irish-bug/ChromaCade/docs/TSynth.png

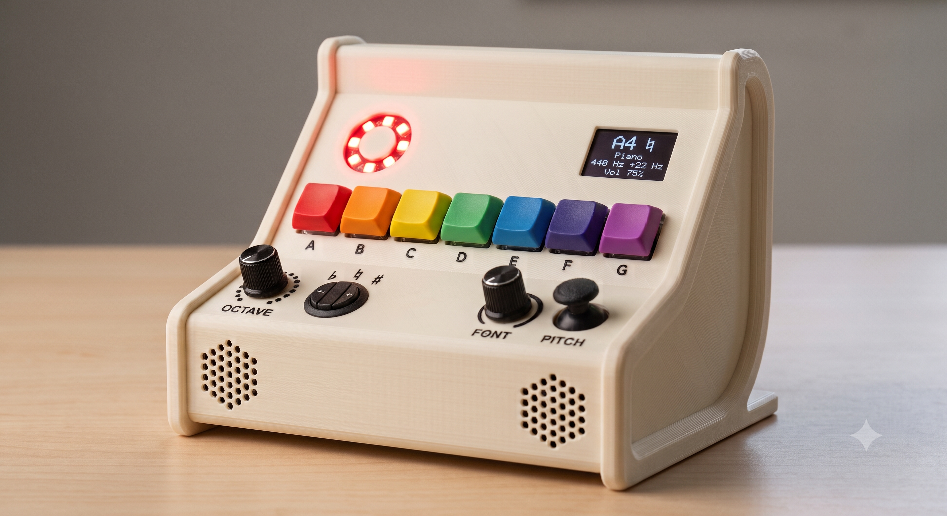
docs/TSynth.png
