irish-bug/ChromaCade/README.md

# ChromaCade
ChromaCade: A learning platform for young musicians. This project aims to create a robust and intuitive self exploration musical learning platform for musically precocious toddlers of all ages.
