irish-bug/ChromaCade/hardware/control-layout.md

# Control Layout — Toddler Synth

## Physical zones

**Main angled panel (45°):**
- 7 note buttons (MX switches, rainbow keycaps), left to right = low to high, letter names A–G
- OLED display (note name, font, frequency+bend, volume)
- WS2812 LED ring, mounted next to the OLED

**Shelf (flat, slight forward tilt, between front wall and angled panel):**
- **Far left:** octave encoder (EC11, detented, wraps 1→2→3→4→1) + flat/natural/sharp rocker switch (3-way, ON-OFF-ON), positioned together as the left-hand "setup" cluster
- **Far right:** font/voice encoder (EC11, detented, wraps through voice list) + pitch-bend joystick (KY-023, spring-centered, one axis), positioned together as the right-hand "live shaping" cluster

**Side panel:**
- Volume pot (Fender 500K) — deliberately less convenient than shelf/panel controls

**Front wall:**
- Two speaker grilles (small hex hole pattern, sized to keep toddler fingers out)

**Back wall:**
- USB-C charging port — out of reach during normal play
- Power switch (miniature snap-in rocker, 19.2×12.7mm panel cutout) — moved here from the side panel; same deliberate-friction reasoning, and grouping it with the charging port keeps both "parent-only" power-path controls out of reach during play

## Normal play behavior
- Direct GPIO wiring (no button matrix) — full chord support, no ghosting, any combination of the 7 note buttons can be held simultaneously
- Flat/natural/sharp switch is **global** — applies to all currently-held notes uniformly. A chord can be all-natural or all-modified, never mixed (e.g. no C–E–G♯ chords). This is an accepted, deliberate simplification (see design-philosophy.md).
- Octave applies globally too, via the octave encoder — not per-note
- Pitch-bend joystick affects all currently-held notes' pitch together, live, while held; snaps back to zero on release (spring-centered)
- LED ring shows a **unified color** for the whole ring (not per-note-position) — reflects the currently-played note's base hue, shifted warmer for sharp / cooler for flat. Chord color-blending behavior is an open question — see open-questions.md.
- OLED shows four lines, live-updating: note+accidental (large), font name, base frequency + signed pitch-bend offset in Hz (shown separately, not summed — e.g. "440 Hz +22 Hz" — to reinforce that bend modifies rather than replaces the note), volume percentage

## Menu / mode interaction grammar
Designed to survive toddler mashing — every menu action requires a multi-control combo, since a plain long-press on a note button is not a safe gesture on its own (toddlers routinely hold single notes just to sustain the sound — see "Corrected 2026-08-15" below for why that matters).

- **Toggle mode menu (open from anywhere else, close from the menu):** hold **both** encoder push-buttons (octave encoder's and font encoder's) together for ~1.5s. From an active Tutor/Simon session this stops the session and opens the menu; from the menu itself it closes back to Play.
- **Cycle through menu options:** turn the font encoder (menu takes over that control's normal job while a menu is open)
- **Select a highlighted option:** short click of the font encoder's push-button

**Simplified 2026-08-16 — dropped the note-button long-press.** Previously this was hold-both-encoders **and** long-press an edge note button (B to enter, C to exit) — see history below for why it was two notes and both encoders in the first place. In practice the extra note-button press just added friction without adding safety: both encoder push-buttons held together is already a two-handed, opposite-ends-of-the-shelf signal on its own, rare enough that a third simultaneous note-button long-press wasn't buying meaningfully more protection against toddler mashing. Collapsing enter/exit into one toggle (state-dependent: open the menu unless already in it, in which case close it) also removes the need to remember two different notes for two different directions.

**Corrected 2026-08-15 — was originally A/G + font-button-only, implemented as C/B + both-encoder-buttons:** two separate issues, fixed together (superseded by the 2026-08-16 simplification above, kept here for history).
1. This section originally said "long-press G to enter, A to exit," reasoning that they were the two edge buttons — true under the *old* alphabetical A-G labeling, but the 2026-08-15 relabel to C-D-E-F-G-A-B moved the physical edges to C and B; A and G became interior buttons. Updated the letters to match, not the underlying "edge button" reasoning.
2. The original design paired the font button alone (as a held modifier) with the note-button long-press. In practice a note-button long-press isn't a rare, deliberate signal — a toddler sustaining a single held note *is* a long-press, all day, during completely normal play. Requiring **both** encoder push-buttons (not just the font one) closes that gap: they sit at opposite ends of the shelf (far left = octave, far right = font), so holding both down is inherently two-handed and not something normal note-sustaining play does incidentally.

This also resolves the octave encoder push-button's previously-unassigned function (see hardware-bom.md/open-questions.md history): it's one of the two buttons in this gesture, not read for anything else yet.

**Note on implementation:** the font encoder's push-button is overloaded across two contexts — held-as-modifier (menu toggle, alongside the octave button) and short-click (menu selection). Implemented in `hardware_poller.py` via a press/release timestamp (short click) plus a `threading.Timer` armed the instant both encoder buttons are simultaneously down and cancelled the instant either releases, so the gesture only fires if both stayed held for the full ~1.5s — see that module's docstring for the exact approach.

**Resolved 2026-08-15 (was open):** A/C/B/G note buttons do *not* play notes while a menu is active — the menu takes over input entirely, confirmed as implemented in `chromacade.py`. Visual feedback: the OLED switches to a menu view (mode/song list, current selection marked), and the LED ring clears while a menu is open. Menu structure is nested (mode select, then a song list within Tutor) — see `menu.py`. No song preview/snippet plays before selecting.
