irish-bug/ChromaCade/enclosure/ChromaCade-wordmark.png

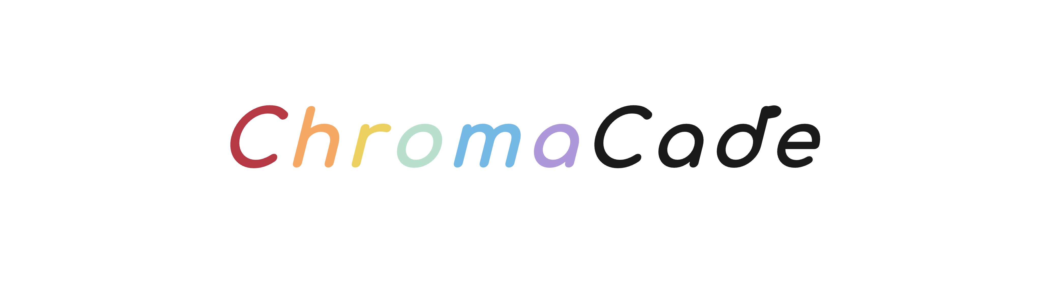
enclosure/ChromaCade-wordmark.png
