irish-bug/ChromaCade/enclosure/fan-dimensions.jpg

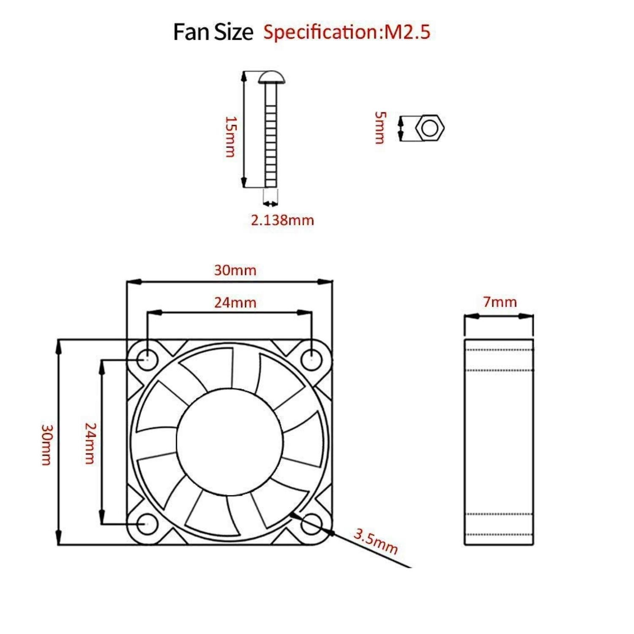
enclosure/fan-dimensions.jpg
