irish-bug/ChromaCade/hardware/speaker_specs.jpeg

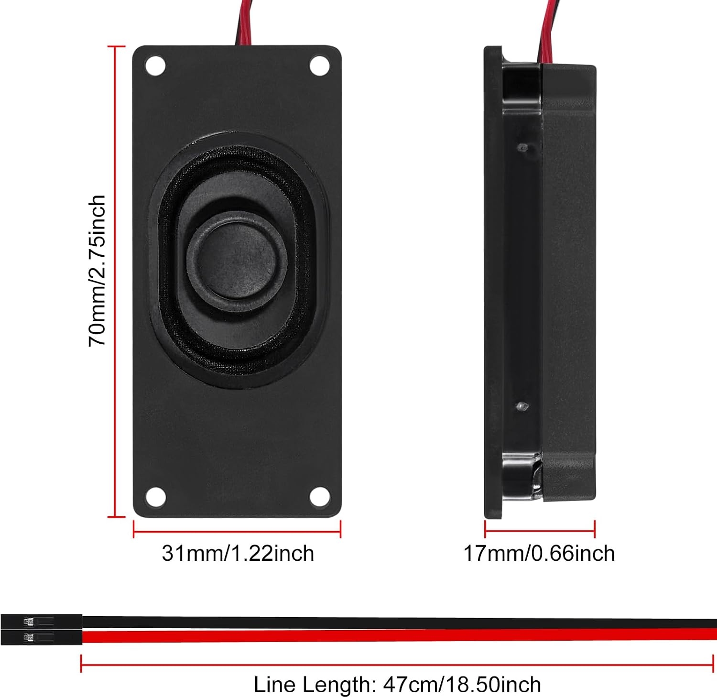
hardware/speaker_specs.jpeg
