irish-bug/ChromaCade/enclosure/chromacade-housing.stl

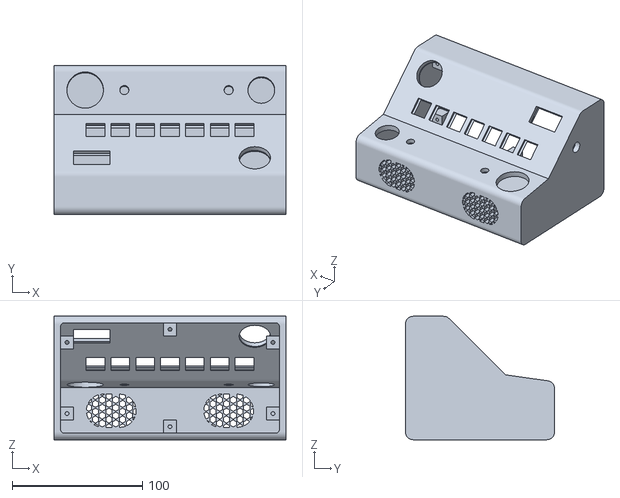
[picture p5: CAD file, 2026-07-22]
enclosure/chromacade-housing.stl
177.8 x 114.3 x 94.7
