irish-bug/ChromaCade/enclosure/deprecated/sphere-removed.stl

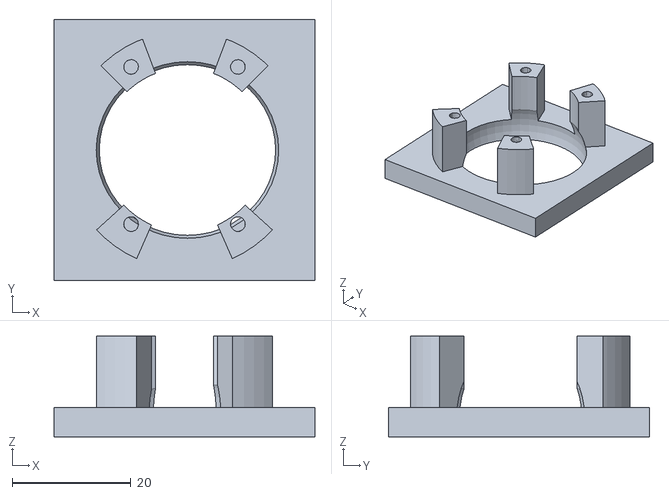
[picture p7: CAD file, 2026-08-28, an earlier design]
enclosure/deprecated/sphere-removed.stl
44.0 x 44.0 x 17.0
