irish-bug/ChromaCade/enclosure/deprecated/chromacade-pot-side.stl

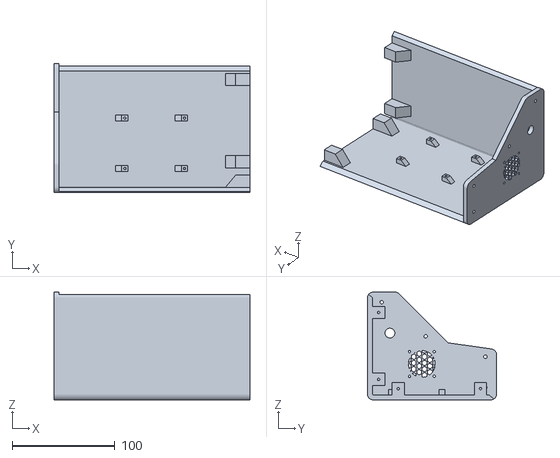
[picture p8: CAD file, 2026-08-28, an earlier design]
enclosure/deprecated/chromacade-pot-side.stl
190.4 x 125.7 x 104.9
