irish-bug/ChromaCade/enclosure/deprecated/test-mk2.stl

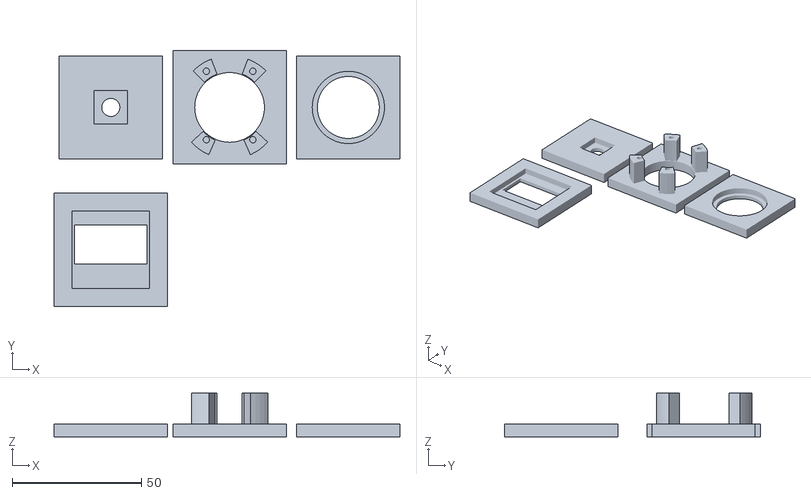
[picture p9: CAD file, 2026-08-28, an earlier design]
enclosure/deprecated/test-mk2.stl
134.0 x 99.0 x 17.0
