irish-bug/ChromaCade/enclosure/deprecated/chromacade-blank-side.stl

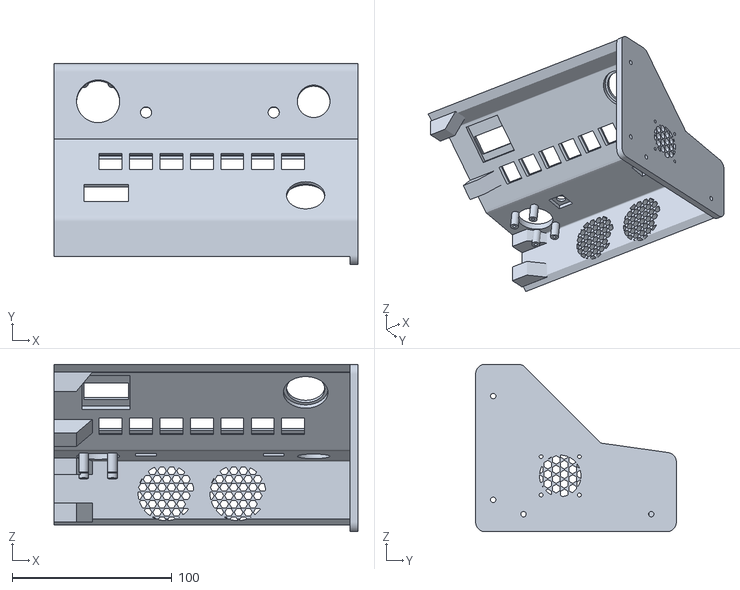
[picture p10: CAD file, 2026-08-28, an earlier design]
enclosure/deprecated/chromacade-blank-side.stl
190.4 x 125.7 x 104.9
