irish-bug/ChromaCade/(list of files, cad)

Other CAD files:
enclosure/blank-side-one-off.scad
enclosure/chromacade-housing.scad
enclosure/deprecated/chromacade-blank-side-embossed.scad
enclosure/deprecated/chromacade-blank-side-thinner.scad
enclosure/deprecated/chromacade-blank-side.scad
enclosure/deprecated/chromacade-fit-check-thinner.scad
enclosure/deprecated/chromacade-fit-check.scad
enclosure/deprecated/chromacade-housing.scad
enclosure/deprecated/chromacade-pot-side-thinner.scad
enclosure/deprecated/chromacade-pot-side.scad
enclosure/deprecated/joystick-mount-dev.scad
enclosure/deprecated/test-mk2.scad
