irish-bug/ChromaCade/testing/led_ring16_test.py

#!/usr/bin/env python3
"""
ChromaCade -- candidate "NeoPixel Ring 16" bench test.

Not the project's decided ring/strip (see led_ring_test.py for those) --
this is a bench evaluation of a different, not-yet-committed 16-LED ring
being tried as a possible swap-in. Wire only 3 of its 6 pads for this
test: 5V, GND, and DIN. Leave the unlabeled pad and the "Power & Signal"
pad disconnected until their function is confirmed (e.g. via a
continuity check against the 4 known pads) -- guessing at those risks
frying the ring or a GPIO pin.

    DIN -> GPIO12, PHYSICAL PIN 32 (PWM0) -- NOT physical pin 12.
           Physical pin 12 is GPIO18, which this build's I2S audio
           (WM8960 HAT) already claims for BCLK -- see
           gpio-pin-assignments.md's WS2812 ring entry, which calls
           this out by name as "a common conflict with the default
           rpi_ws281x example code". GPIO12/pin 32 is the pin the
           project's real ring already uses successfully.
    VCC -> Pi 5V rail
    GND -> any Pi GND

Cycles 7 generic/textbook RGB values (not this project's tuned
docs/color-palette.md hexes -- see led_ring_test.py's history or
git blame on this file for those) -- red, orange, yellow, green, blue,
purple, pink, in that order. Just a plain color-rendering check for
this candidate ring, not a comparison against the project's actual
palette.

Prerequisites:
    pip3 install adafruit-circuitpython-neopixel --break-system-packages

Must be run with sudo -- WS2812 output on the Pi uses PWM/DMA hardware
that needs root access.

Usage:
    sudo python3 led_ring16_test.py
    sudo python3 led_ring16_test.py --num-pixels 16 --hold 1.5
    sudo python3 led_ring16_test.py --pixel-order RGB   # if colors look swapped
    sudo python3 led_ring16_test.py --rgb 255,75,0      # hold one color, tune live, Ctrl+C to stop
"""

import argparse
import sys
import time

try:
    import board
    import neopixel
except ImportError:
    print("Missing dependency. Install with:")
    print("    pip3 install adafruit-circuitpython-neopixel --break-system-packages")
    sys.exit(1)

# All 7 live-tuned against this specific candidate ring via --rgb,
# 2026-08-20. Started from full-saturation primaries for red/green/blue
# (matching led_ring_test.py's own COLOR_STEPS convention) and generic/
# textbook CSS values for the rest -- green reads stronger than its
# numeric value on this hardware, same effect docs/color-palette.md
# found on the project's real ring (see that file for the general
# phenomenon). Every entry ended up far dimmer than its starting point,
# not just rebalanced -- full CSS/full-saturation brightness read as
# washed-out/pastel (purple specifically read as pink at CSS 128,0,128),
# same effect color-palette.md describes for the project's real ring.
# Converged on a max-channel-88 ceiling across the whole set (~1/3 of
# full output, chosen for that headroom -- and, not incidentally, 88mph).
#
# Confirmed 2026-08-20, seeing all 7 together at the 88 ceiling: lower
# intensity doesn't just fix individual problem colors, it makes EVERY
# color read more distinct and "less white" across the board, not only
# the ones that were visibly wrong at full brightness. Consistent with
# color-palette.md's "additive light reads washed-out near-white"
# point, but sharper -- it's specifically an intensity effect, not just
# additive-vs-reflective: even colors that looked fine alone at full
# brightness (red/green/blue) read more washed out than they needed to,
# it just wasn't obvious until compared side by side with the dimmed
# set. Worth keeping in mind for any future WS2812 palette work, not
# just this ring: check a candidate color's distinctness at a lower
# ceiling before assuming full-saturation is the right starting point.
COLORS = [
    ("red",    (88, 0, 0)),      # TUNED 2026-08-20 (was full-sat 255,0,0)
    ("orange", (88, 15, 0)),     # TUNED 2026-08-20 (was CSS 255,165,0; first pass 255,50,0)
    ("yellow", (88, 55, 0)),     # TUNED 2026-08-20 (was CSS 255,255,0; passes 255,190,0, 125,85,0, 88,60,0)
    ("green",  (0, 88, 0)),      # TUNED 2026-08-20 (was full-sat 0,255,0)
    ("blue",   (0, 0, 88)),      # TUNED 2026-08-20 (was full-sat 0,0,255)
    ("purple", (40, 0, 88)),     # TUNED 2026-08-20 (was CSS 128,0,128; first pass 10,0,24)
    ("pink",   (88, 0, 35)),     # TUNED 2026-08-20 (was CSS 255,192,203; first pass 255,0,100)
]


def main():
    parser = argparse.ArgumentParser(description="ChromaCade candidate 16-LED ring bench test")
    parser.add_argument("--pin", default="D12",
                         help="board pin attribute for DIN (default D12 = GPIO12 = physical pin 32)")
    parser.add_argument("--num-pixels", type=int, default=16,
                         help="pixel count (default 16, per the ring's name -- override if it's actually different)")
    parser.add_argument("--brightness", type=float, default=0.2,
                         help="0.0-1.0, conservative default to keep current draw low on the bench (default 0.2)")
    parser.add_argument("--hold", type=float, default=1.0,
                         help="seconds to hold each color (default 1.0)")
    parser.add_argument("--pixel-order", default="GRB", choices=["RGB", "GRB"],
                         help="most WS2812/WS2812B are GRB; try RGB if colors come out swapped (default GRB)")
    parser.add_argument("--rgb", default=None,
                         help="skip the sequence and hold one custom color instead, e.g. --rgb 255,75,0 "
                              "-- for iterating on a value live without a re-push/re-pull round trip; "
                              "holds until Ctrl+C")
    args = parser.parse_args()

    order = neopixel.GRB if args.pixel_order == "GRB" else neopixel.RGB

    try:
        pixel_pin = getattr(board, args.pin)
    except AttributeError:
        print(f"ERROR: board.{args.pin} not found -- check your adafruit-blinka install/platform detection.")
        sys.exit(1)

    try:
        pixels = neopixel.NeoPixel(
            pixel_pin, args.num_pixels, brightness=args.brightness,
            auto_write=False, pixel_order=order,
        )
    except PermissionError:
        print("ERROR: permission denied initializing the chain.")
        print("WS2812 output needs PWM/DMA hardware access -- run this with sudo:")
        print("    sudo python3 led_ring16_test.py")
        sys.exit(1)

    print(f"Candidate ring -- board.{args.pin}, {args.num_pixels} pixels, pixel_order={args.pixel_order}")
    print("If colors look swapped (e.g. red shows as green), re-run with --pixel-order RGB.")
    print("If the first pixel looks wrong/flickery while the rest are fine, that's the classic")
    print("3.3V-GPIO-driving-a-5V-chain symptom -- a logic-level shifter (74AHCT125) may be needed.")
    print()

    if args.rgb:
        try:
            r, g, b = (int(x) for x in args.rgb.split(","))
        except ValueError:
            print(f"ERROR: --rgb must be R,G,B e.g. --rgb 255,75,0 (got {args.rgb!r})")
            sys.exit(1)
        print(f"Holding ({r},{g},{b}) -- Ctrl+C to stop")
        pixels.fill((r, g, b))
        pixels.show()
        try:
            while True:
                time.sleep(3600)
        except KeyboardInterrupt:
            print("\nStopped.")
        finally:
            pixels.fill((0, 0, 0))
            pixels.show()
        return

    try:
        for name, rgb in COLORS:
            print(f"  {name:8s} {rgb}")
            pixels.fill(rgb)
            pixels.show()
            time.sleep(args.hold)
        print("Sequence complete.")
    except KeyboardInterrupt:
        print("\nInterrupted.")
    finally:
        pixels.fill((0, 0, 0))
        pixels.show()


if __name__ == "__main__":
    main()
