irish-bug/ChromaCade/test_audio_engine.py

import pytest

from audio_engine import (
    FONTS,
    NOTE_SEMITONES,
    VOLUME_CEILING,
    bent_letter,
    clamp_octave,
    font_index_change,
    joystick_bend_fraction,
    midi_note,
    midi_to_freq,
    pitch_bend_value,
    pot_volume_fraction,
    rocker_accidental,
    smooth,
    volume_midi_value,
)


def test_note_semitones_covers_all_seven_letters():
    assert set(NOTE_SEMITONES.keys()) == {"C", "D", "E", "F", "G", "A", "B"}


def test_c4_is_midi_60():
    assert midi_note("C", octave=4) == 60


def test_a4_is_midi_69_the_440hz_reference():
    assert midi_note("A", octave=4) == 69


def test_midi_69_is_440hz():
    assert midi_to_freq(69) == pytest.approx(440.0)


def test_midi_to_freq_one_octave_up_doubles():
    assert midi_to_freq(69 + 12) == pytest.approx(880.0)


def test_midi_to_freq_one_octave_down_halves():
    assert midi_to_freq(69 - 12) == pytest.approx(220.0)


def test_all_seven_letters_at_octave_4():
    expected = {"C": 60, "D": 62, "E": 64, "F": 65, "G": 67, "A": 69, "B": 71}
    for letter, note in expected.items():
        assert midi_note(letter, octave=4) == note


def test_octave_shift_moves_by_twelve_semitones():
    assert midi_note("C", octave=5) - midi_note("C", octave=4) == 12
    assert midi_note("C", octave=3) - midi_note("C", octave=4) == -12


def test_sharp_raises_one_semitone():
    assert midi_note("C", octave=4, accidental=1) == midi_note("C", octave=4) + 1


def test_flat_lowers_one_semitone():
    assert midi_note("C", octave=4, accidental=-1) == midi_note("C", octave=4) - 1


def test_octave_0_and_8_match_the_confirmed_range():
    # feature-spec.md: 8 octaves, C0-C8, confirmed via live speaker sweep
    assert midi_note("C", octave=0) == 12
    assert midi_note("C", octave=8) == 108


def test_clamp_octave_moves_within_range():
    assert clamp_octave(4, 1) == 5
    assert clamp_octave(4, -1) == 3


def test_clamp_octave_stops_at_the_confirmed_floor_and_ceiling():
    assert clamp_octave(0, -1) == 0
    assert clamp_octave(8, 1) == 8


def test_clamp_octave_handles_a_runaway_gesture_in_one_step():
    # a whole burst of clicks still only ever moves one octave per
    # commit()ed gesture, but clamp_octave itself should be safe even
    # if called with a larger delta than that
    assert clamp_octave(0, -5) == 0
    assert clamp_octave(8, 5) == 8


def test_rocker_accidental_natural_when_neither_throw_active():
    assert rocker_accidental(flat_active=False, sharp_active=False) == 0


def test_rocker_accidental_flat_throw():
    assert rocker_accidental(flat_active=True, sharp_active=False) == -1


def test_rocker_accidental_sharp_throw():
    assert rocker_accidental(flat_active=False, sharp_active=True) == 1


def test_rocker_accidental_both_active_is_a_wiring_fault_falls_back_natural():
    assert rocker_accidental(flat_active=True, sharp_active=True) == 0


def test_joystick_bend_fraction_at_center_is_zero():
    assert joystick_bend_fraction(1.65) == pytest.approx(0.0, abs=0.01)


def test_joystick_bend_fraction_low_voltage_is_positive_sharp():
    # confirmed inverted as wired -- forward push reads as lower voltage
    # but should mean sharp/positive bend
    assert joystick_bend_fraction(0.0) == pytest.approx(1.0, abs=0.01)


def test_joystick_bend_fraction_high_voltage_is_negative_flat():
    assert joystick_bend_fraction(3.3) == pytest.approx(-1.0, abs=0.01)


def test_joystick_bend_fraction_clamped_past_measured_extremes():
    assert joystick_bend_fraction(-1.0) == 1.0
    assert joystick_bend_fraction(5.0) == -1.0


def test_pitch_bend_value_zero_at_center():
    assert pitch_bend_value(0.0) == 0


def test_pitch_bend_value_half_semitone_up_at_full_positive_bend():
    assert pitch_bend_value(1.0, max_semitones=0.5) == 1024


def test_pitch_bend_value_half_semitone_down_at_full_negative_bend():
    assert pitch_bend_value(-1.0, max_semitones=0.5) == -1024


def test_pitch_bend_value_clamped_to_valid_synth_range():
    assert pitch_bend_value(1.0, max_semitones=10) == 8191
    assert pitch_bend_value(-1.0, max_semitones=10) == -8192


def test_bent_letter_no_bend_stays_the_same_letter():
    assert bent_letter("C", 0.0) == "C"


def test_bent_letter_e_to_f_is_only_a_half_step():
    # E-F is one of the two half-step pairs -- crosses with a small bend
    # (0.6 semitones of actual bend clears the 0.5-semitone halfway point)
    assert bent_letter("E", 0.6, max_semitones=1.0) == "F"


def test_bent_letter_c_to_d_is_a_whole_step_needs_more_bend():
    # same 0.6-semitone bend that flips E->F should NOT flip C->D
    # (2 semitones apart, halfway point is 1.0 semitones)
    assert bent_letter("C", 0.6, max_semitones=1.0) == "C"


def test_bent_letter_c_to_d_does_flip_with_enough_bend():
    assert bent_letter("C", 1.0, max_semitones=1.0) == "D"


def test_bent_letter_b_to_c_wraps_the_octave_boundary_correctly():
    # B-C is the other half-step pair, and it's the wraparound case
    assert bent_letter("B", 0.6, max_semitones=1.0) == "C"


def test_bent_letter_negative_bend_crosses_to_the_previous_letter():
    assert bent_letter("C", -0.6, max_semitones=1.0) == "B"


def test_bent_letter_stays_home_just_under_the_halfway_point():
    assert bent_letter("E", 0.49, max_semitones=1.0) == "E"


def test_bent_letter_large_bend_crosses_two_boundaries_not_just_one():
    # G bent up a full 4 semitones lands exactly on B's pitch (7+4=11),
    # past A (9) -- must not stop at the first neighbor
    assert bent_letter("G", 1.0, max_semitones=4.0) == "B"


def test_bent_letter_large_bend_partway_between_two_boundaries_shows_middle_letter():
    # G bent up exactly 2 semitones lands exactly on A -- confirms the
    # multi-boundary walk stops at the right letter, not overshooting
    assert bent_letter("G", 0.5, max_semitones=4.0) == "A"


def test_smooth_alpha_one_tracks_new_value_instantly():
    assert smooth(previous=1.0, new_value=2.0, alpha=1.0) == 2.0


def test_smooth_alpha_zero_ignores_new_value_entirely():
    assert smooth(previous=1.0, new_value=2.0, alpha=0.0) == 1.0


def test_smooth_alpha_half_averages_the_two():
    assert smooth(previous=1.0, new_value=3.0, alpha=0.5) == 2.0


def test_pot_volume_fraction_zero_volts_is_silent():
    # No longer inverted -- rewiring since the original 2026-08-14
    # calibration flipped which direction reads high vs low voltage,
    # confirmed live 2026-08-24 (see audio_engine.py's comment).
    assert pot_volume_fraction(0.0) == pytest.approx(0.0, abs=0.01)


def test_pot_volume_fraction_full_voltage_is_full_clockwise_full_volume():
    assert pot_volume_fraction(3.3) == pytest.approx(1.0, abs=0.01)


def test_pot_volume_fraction_clamped_past_measured_extremes():
    assert pot_volume_fraction(-1.0) == 0.0
    assert pot_volume_fraction(5.0) == 1.0


def test_volume_midi_value_zero_is_silent():
    assert volume_midi_value(0.0) == 0


def test_volume_midi_value_full_volume_stops_at_the_safety_ceiling():
    # ceiling default is 0.7 -- full pot turn should never reach 127
    assert volume_midi_value(1.0) == round(0.7 * 127)


def test_volume_midi_value_custom_ceiling():
    assert volume_midi_value(1.0, ceiling=1.0) == 127
    assert volume_midi_value(1.0, ceiling=0.5) == round(0.5 * 127)


def test_volume_midi_value_gamma_curve_boosts_low_and_mid_positions():
    # sqrt(0.25) = 0.5, so the default gamma curve should give roughly
    # double the MIDI value a straight linear mapping would at this
    # pot position -- this is the actual fix for the reported "silent
    # through the lower two-thirds" issue
    linear_equivalent = round(0.25 * VOLUME_CEILING * 127)
    curved = volume_midi_value(0.25)
    assert curved > linear_equivalent


def test_volume_midi_value_gamma_endpoints_unaffected():
    # a gamma curve preserves 0.0 and 1.0 exactly regardless of gamma
    assert volume_midi_value(0.0, gamma=0.3) == 0
    assert volume_midi_value(1.0, gamma=0.3) == round(VOLUME_CEILING * 127)


def test_font_index_change_steps_forward_and_backward():
    assert font_index_change(0, 1, num_fonts=5) == 1
    assert font_index_change(2, -1, num_fonts=5) == 1


def test_font_index_change_wraps_past_the_end():
    assert font_index_change(4, 1, num_fonts=5) == 0


def test_font_index_change_wraps_past_the_start():
    assert font_index_change(0, -1, num_fonts=5) == 4


def test_fonts_list_has_no_duplicate_display_names():
    names = [name for _, name in FONTS]
    assert len(names) == len(set(names))


def test_fonts_list_has_no_duplicate_gm_programs():
    programs = [program for program, _ in FONTS]
    assert len(programs) == len(set(programs))
