irish-bug/ChromaCade/(commit log)

2026-07-18 Add parametric OpenSCAD case model (v2)
    - Arcade-cabinet profile: foot → front wall → shelf → 45° panel → back wall
    - Continuous base slab; all dims parametric at top of file
    - Shelf tilt geometry: polyhedron (flat bottom, 7.5° tilted top); back
    edge rises SHELF_D*tan(7.5°) ≈ 6.7mm relative to front edge
    - Panel base position updated to SHELF_BACK_TOP_Z to match tilted shelf
    - 7 MX switch cutouts (19.05mm pitch), OLED window, LED ring on 45° panel
    - Shelf cutouts: octave encoder + rocker switch (left), font encoder +
    joystick (right); extended height to clear full tilted face
    - Front wall: dual hex speaker grilles (<6mm holes, toddler-safe)
    - Side panel: volume pot + power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
    [chromacade.scad]
2026-07-18 Rename case design document to ChromaCade
2026-07-18 Revise ChromaCade model to version 3
    Updated ChromaCade model to version 3 with structural fixes, improved geometry, and additional features. Changed all face sizes and increased rounding of edges.
    [chromacade.scad]
2026-07-18 Fix comments for synthesizer components in chromacade.scad
    Updated comments to reflect correct component names for the synthesizer model.
    [chromacade.scad]
2026-07-18 Refactor mounting boss and cutout placements
    [chromacade.scad]
2026-07-18 Upgrade ChromaCade Synthesizer to V4
    Updated ChromaCade Synthesizer model to V4 with improvements to back wall, mounting bosses, and back panel screw holes.
    [chromacade.scad]
2026-07-18 Add V4 structural model with BOM-verified cutout corrections
    Based on Shane's V4 paste with all cutout dimensions corrected against
    hardware-bom.md and three-key-test-mount.scad:
    MX switch holes 14.0 → 14.3mm FDM tolerance per test mount
    KY-023 joystick d=10 → d=30mm thumb cap is ~27mm; 10mm blocked it
    XINYIELE rocker d=8 → d=12mm 12mm round body per part spec
    EC11 encoders d=16 → d=7mm M7 bushing OD; 16mm left sloppy gap
    USB-C port 15×7 → 10×4mm standard USB-C receptacle is 9.5×3.5mm
    Speaker grilles circular hex_grill(30) → rect_hex_grill(65, 30)
    Speaker enclosures are rectangular (1-3/8" × 2-3/4" = 34.9×69.9mm).
    Grille sized to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
    [chromacade-v4.scad]
2026-07-18 Add 6-hole component fit test plate
    One 40x40mm plate per unique cutout type, all flat-printable in one go.
    Lets you verify every hole before the full case print.
    A MX switch 14.3 × 14.3mm (1.5mm eng layer + 4mm frame, per test mount)
    B KY-023 joy ø30mm
    C XINYIELE ø12mm
    D EC11 enc ø7mm
    E USB-C 10 × 4mm rect
    F Fender pot ø8mm
    Raised text labels on top face. Includes per-plate tuning notes as comments.
    [test-component-holes.scad]
2026-07-18 Upgrade ChromaCade Synthesizer to V5
    Updated ChromaCade Synthesizer model to V5 with structural improvements and corrected cutout dimensions for various components.
    [chromacade.scad]
2026-07-18 Fix rocker switch hole: 12mm → 20.32mm (0.8 inch spec)
    Previous 12mm was a guess based on generic round rocker convention.
    Shane confirmed the XINYIELE body requires 0.8" = 20.32mm panel hole.
    Updated in both chromacade-v4.scad and test-component-holes.scad.
    [chromacade-v4.scad, test-component-holes.scad]
2026-07-18 Add test plates for LED ring and OLED display, fix rocker comments
    [test-component-holes.scad]
2026-07-18 Revise cutouts based on printed test results; add mk2 test plates
    BOM-verified corrections applied to chromacade.scad:
    - Rocker: d=12 (regression) → d=20.5 (confirmed snug fit from test print)
    - Joystick: d=30 → d=28, Y offset removed (re-centred)
    - Encoders: d=7 kept; add 14.3×14.3mm back countersink 1mm deep for thread clearance
    - OLED: 28×15 front window kept; add 30×30mm back countersink 2mm deep
    - LED ring: d=24 front aperture (exposes full 23mm LED circle); d=28 back recess 1mm
    deep — ring glues in from behind, ~1.3mm gap around 25.4mm PCB
    - USB-C: 10×4 → 14×10 to accommodate cable sheath over bare receptacle
    - Speaker grilles: rect_hex_grill(65,30) → stadium_hex_grill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
    [chromacade.scad, test-component-holes.scad, test-mk2.scad]
2026-07-18 Remove labels from JOY, LED, OLED test plates to prevent print failures
    Labels on all three overlapped with their cutouts (d=28 hole/recess fills
    the 40mm plate, OLED 30×30 countersink undercuts the label position).
    ENC and SPK labels are clear of their cutouts and unchanged.
    [test-mk2.scad]
2026-07-18 Fix countersink faces and rotate speaker grilles 90°
    Speaker grilles: add rotate([0,0,90]) — was portrait (1"×1.5" tall),
    now landscape (1.5"×1" wide) to match the front wall proportions.
    Countersink Z positions: all three were at -(wall-depth)/2 which placed
    them mid-wall rather than at the interior face. Interior face is at
    local Z=-wall, so correct center positions are -(wall-depth/2):
    - Encoder (1mm): -(wall-1)/2=-2 → -(wall-0.5)=-4.5
    - OLED (2mm): -(wall-2)/2=-1.5 → -(wall-1) =-4
    - LED ring(1mm): -(wall-1)/2=-2 → -(wall-0.5)=-4.5
    [chromacade.scad]
2026-07-18 Add STL of the unit.
    Unit with verified cutout sizes, sinks, and dimensions.
    [chromacade.stl]
2026-07-19 Extract speaker grilles into separate printable inserts
    Printing upright (the intended orientation) puts the grilles right beneath
    the shelf overhang. The resulting support material would clog the tiny
    hex holes and be incredibly tedious to scrape out.
    - Replaced the hardcoded hex grilles on the front wall with open 65x30mm windows.
    - Created a new module.
    - Insert features a 5mm mounting rim to glue/tape to the inside of the front wall.
    - Insert is 2mm thick (thinner than case walls for better acoustics) and
    prints flat on the bed.
    [chromacade-v4.scad]
2026-07-19 Upgrade grille inserts to stepped flush-mount design with screw flanges
    - Grille insert now features a 5mm plug that sits flush with the exterior face of the case.
    - Base of insert is a 2mm flange that sits against the inside wall.
    - Added 4x 2.5mm screw holes to the corners of the flange.
    - Added corresponding blind pilot holes to the inside of the front wall (they go 3mm deep, leaving the front face perfectly clean).
    [chromacade-v4.scad]
2026-07-19 Consolidate to single chromacade.scad file and bump to Version 6
    - Removed the separate chromacade-v4.scad file.
    - We are now tracking versions through standard git history and a changelog header in the main chromacade.scad file.
    - Logged the recent V6 upgrades (stepped flush grilles with screw flanges).
    [chromacade-v4.scad, chromacade.scad]
2026-07-19 Split monolithic SCAD into modular files
    - Extracted global variables to `chromacade-config.scad`.
    - Extracted grille inserts to `speaker-grille-insert.scad`.
    - Extracted back panel to `back-panel.scad`.
    - Renamed main file to `chromacade-housing.scad`, which uses/includes the other files.
    [back-panel.scad, chromacade-config.scad, chromacade-housing.scad, chromacade.scad, speaker-grille-insert.scad]
2026-07-19 Disable back panel preview in housing for clean STL exports
    [chromacade-housing.scad]
2026-07-19 Revert to monolithic file with export toggles
    User's workflow relies on pasting raw code directly into unsaved OpenSCAD windows
    on a separate machine. The modular architecture broke this workflow.
    Consolidated back into a single `chromacade.scad` file, and added boolean
    toggles at the very top of the file to choose which part to render and export.
    [back-panel.scad, chromacade-config.scad, chromacade-housing.scad, chromacade.scad, speaker-grille-insert.scad]
2026-07-19 Completely unlinked standalone files
    User requested 3 entirely independent files with no shared dependencies
    to mimic the distribution style of Printables/Thingiverse.
    Variables were duplicated into each file so they can be copy-pasted or
    downloaded and rendered completely on their own.
    [chromacade-back-panel.scad, chromacade-housing.scad, chromacade-speaker-grilles.scad, chromacade.scad]
2026-07-19 Restore component countersinks to hardware_cutouts
    Accidentally dropped the EC11, OLED, and LED ring back sinks during the
    refactor from V4 to V5. Also finally added the MX switch trench to the main
    model (3.5mm deep, leaving a 1.5mm front face for the clips to engage, just
    like in the test plates).
    [chromacade-housing.scad]
2026-07-19 Shift shelf components to clear side walls
    User noted the joystick cutout (at -70) was colliding with the side wall.
    Shifted the joystick from X=-70 to -65, and shifted the left EC11 encoder
    from X=-45 to -35 to maintain clearance.
    [chromacade-housing.scad]
2026-07-19 Fix speaker grille flange collision and back panel bowing
    - Redesigned the speaker grille flange to only extend left and right, ensuring
    it stays within the bounds of the internal front cavity. The top and bottom
    edges were colliding with the shelf ceiling and case floor. Pilot holes in the
    housing were adjusted accordingly.
    - Added top and bottom center mounting bosses to the housing and corresponding
    screw holes to the back panel to prevent the long span from bowing out.
    [chromacade-back-panel.scad, chromacade-housing.scad, chromacade-speaker-grilles.scad]
2026-07-19 Fix floating center bosses, cut grilles into front wall, relocate power switch
    - Removed the top/bottom center mounting bosses added in the previous commit
    to fight back-panel bowing — render confirms they were floating/disconnected
    from the shell (unprintable), and no replacement fix exists yet.
    - Replaced the rectangular speaker grille + separate screwed insert with a
    landscape stadium (pill) hex-hole pattern cut straight into the front wall
    (stadium_hex_grill module), matching the validated test-mk2.scad plate E
    design. Deleted chromacade-speaker-grilles.scad and the stale chromacade.stl
    that predated the file split.
    - Restored print-confirmed rocker (20.5mm) and joystick (2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
    [chromacade-back-panel.scad, chromacade-housing.scad, chromacade-housing.stl, chromacade-speaker-grilles.scad, chromacade.stl]
2026-07-19 Square off mounting bosses for full contact with the side wall
    The round boss (d=10) was positioned exactly one radius from the side
    wall's inner face, so it only ever line-contacted the flat wall at a
    single tangent point instead of bonding to it — a weak connection and
    a real risk of a barely-fused, snap-off boss when printed. Squaring
    the outer cross-section to 10x10mm (still centered on the same axis,
    same screw-hole diameter) puts a full flush 10x10mm face against the
    wall in its place. Render-confirmed manifold, still a single connected
    solid (no new floating geometry or collisions).
    [chromacade-housing.scad]
2026-07-19 Add center top/bottom bosses for back-panel anti-bowing support
    Reintroduces the center bosses removed earlier (they floated: reused
    the side bosses' X-inset at x=0, where there's no side wall to touch).
    This time they're Z-offset instead of X-offset — 5mm in from the
    ceiling/floor's inner surface — so the square boss (from the previous
    commit) sits flush against the ceiling/floor rather than touching
    nothing. Render-confirmed still a single connected volume, same as
    before adding them.
    Back panel gets two matching 3.5mm screw holes at the same x=0
    position to bolt into the new bosses.
    [chromacade-back-panel.scad, chromacade-housing.scad]
2026-07-19 Add wordmark-embossed housing variant
    Separate standalone file (chromacade-housing-embossed.scad), not a
    toggle in the base housing file, matching this repo's file-per-variant
    convention. Raises "ChromaCade" 1mm proud of the panel exterior,
    centered in the gap between the OLED and LED ring cutouts (x=3.5,
    the midpoint of their facing edges), sized to 84x11mm to clear both
    the button row above and the panel edges.
    Uses OpenSCAD's native text() with Comfortaa Bold (installed via apt;
    falls back to a default font if missing) plus a manual shear to
    approximate the source wordmark's italic style, since Comfortaa ships
    no italic face. The letters' extrusion starts 0.3mm inside the wall
    rather tha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
    [chromacade-housing-embossed.scad]
2026-07-19 Record note key color palette
    Adds color-palette.md with the hex values for the note key colors.
    Letter-to-color assignment and chord-blend validation are still open
    (cross-referenced from open-questions.md's existing "physical button
    color vs. ring color mapping" item, not resolving it outright).
    Also fixes CLAUDE.md's file list, which still described the deleted
    chromacade-speaker-grilles.scad insert file, and adds the missing
    chromacade-housing-embossed.scad entry from the previous commit.
2026-07-19 Switch wordmark emboss to the traced-path SVG
    Replaces the text()+shear approximation with a direct import of
    ChromaCade-wordmark-paths.svg (real bold-italic bezier outlines) so
    the emboss no longer depends on Comfortaa being installed on whatever
    machine renders/slices it — that font-substitution mismatch was why
    the first print came out in a plain, non-bold, non-italic font.
    Positioning bug caught before this went out again: centering used a
    bounding-box center measured by round-tripping the import through an
    SVG re-export, but that export silently negates Y on the way out, so
    the value was off-sign. Re-measured the true center via an extruded
    STL export instead (79.9-284.2mm x, 40.7-62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
    [chromacade-housing-embossed.scad]
2026-07-19 Embed wordmark outline as literal polygon data, drop import()
    Converts ChromaCade-wordmark-paths.svg's line-segment path data into
    embedded wordmark_points/wordmark_paths arrays and switches
    wordmark_emboss() to polygon(points=..., paths=...) instead of
    import("ChromaCade-wordmark-paths.svg"). The conversion is exact (the
    source paths are already flattened to straight segments, no curves
    approximated).
    Reason: import() requires OpenSCAD to read a second local file, which
    prompted a filesystem-permission dialog on at least one setup and got
    declined without realizing it was for the wordmark SVG sitting right
    there — silently breaking the emboss. Embedding removes that
    dependency entirely,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
    [chromacade-housing-embossed.scad]
2026-07-19 Fix wordmark orientation: rotate 180 degrees to match real facing direction
    Second upside-down print. Root cause: I'd been validating orientation
    by eyeballing renders from arbitrary, never-actually-verified camera
    angles, so my "looks right side up" judgment calls weren't grounded in
    the toy's real facing direction and got it backwards twice.
    Fixed properly this time: derived a camera aimed mathematically straight
    down the panel's own outward normal (computed from panel_a and the p3/p4
    midpoint, not eyeballed), then validated it against known, unambiguous
    geometry — LED ring is a circle, OLED is a rectangle, and per the user
    the LED should read on their left, OLED on their right, with th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
    [chromacade-housing-embossed.scad]
2026-07-20 Add print settings for ELEGOO NEPTUNE 3 Pro
2026-07-20 Log software-setup decisions and open GAIN question from today's hardware bring-up
    Records the hifiberry-dac/asound.conf/no-venv calls made during the 3-key
    test mount + amp #1 bring-up so future sessions don't re-propose the
    tutorial-default max98357a overlay or a venv-based setup. Adds the still-open
    amp GAIN pin choice to open-questions.md.
2026-07-20 Update GAIN status: wired to GND (12dB), still not loud enough
    Resolves the floating-vs-GND part of the open question from earlier today;
    15dB-via-100k-resistor is the next thing to try if 12dB alone doesn't get
    loud enough.
2026-07-20 Bump note_test.py AMPLITUDE to 0.9 for loudness check, fix stale comment
    [note_test.py]
2026-07-20 Fix stale doc/comment references from the wordmark-embossed switch
    - CLAUDE.md: correct chromacade.stl -> chromacade-housing.stl, document
    printsettings, and mark chromacade-housing-embossed.scad as the current
    primary housing model (plain variant kept until its print is validated)
    - chromacade-housing-embossed.scad: drop the leftover Comfortaa-font header
    comment, which no longer matches the embedded-polygon wordmark approach
    [chromacade-housing-embossed.scad]
2026-07-20 Reorganize repo into docs/, hardware/, enclosure/, testing/, audio/
    Consolidates shane/seed-project-docs, artoo/case-openscad-model, and
    hardware-config (which no longer needed a separate branch once main gets
    this structure) into one folder layout instead of a flat root, grouping
    files by function rather than by which branch happened to add them:
    - docs/ design/decision docs, open questions, team/task breakdown
    - hardware/ electronics docs (GPIO map, BOM, control layout)
    - enclosure/ the OpenSCAD case model + printable assets + fit-test plates
    - testing/ hardware bring-up/bench-test scripts + session test-plan docs
    - audio/ placeholder only -- brian/core-audio-engine (PR #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
    [chromacade-back-panel.scad, chromacade-housing-embossed.scad, chromacade-housing.scad, chromacade-housing.stl, test-component-holes.scad, test-mk2.scad]
2026-07-21 Add ADS1115 bring-up test, lock its channel/address wiring, verify amp #2
    - Document the single ADS1115's ADDR/A0/A1/VDD/GND wiring in
    gpio-pin-assignments.md: ADDR->GND (address 0x48), A0=volume pot,
    A1=joystick axis.
    - Add testing/ads1115_test.py: live-reads both channels so pot/joystick
    wiring can be confirmed on the bench, with a min/max/span summary to
    catch a flat/stuck channel.
    - audio_test.py: turn the "listen for both speakers" step into an actual
    interactive pass/fail check now that amp #2 exists, and update the
    stale amp-#1-only expectation text.
    [ads1115_test.py, audio_test.py]
2026-07-21 Document post-push sync step to the physical chromacade board
    After pushing, SSH to the chromacade host and git pull its
    /home/shane/ChromaCade/ checkout to keep it in sync -- with a safety
    check first (clean working tree, branch actually tracks what was pushed).
2026-07-21 Fix ADS1115 A0/A1 assignment to match hardware_poller.py, not an invented one
    Swap: A0=joystick axis, A1=volume pot. The Adafruit ADS1x15 library's
    ADS.P0/P1 constants just name physical A0/A1, not a separate channel
    numbering, so this has to match Brian's already-written
    joystick_chan=P0 / volume_chan=P1 rather than a channel order I made up
    before checking his code.
    [ads1115_test.py]
2026-07-22 Fix regressed volume pot side-hole: 8mm -> 9.525mm (3/8") for Fender 500K
    Unit #1 needed the hole hand-drilled out to fit the pot's mounting
    bushing. Fixed in both chromacade-housing.scad and
    chromacade-housing-embossed.scad (same shared cutout, copy-pasted per
    the file-split convention) and regenerated chromacade-housing.stl.
    [chromacade-housing-embossed.scad, chromacade-housing.scad, chromacade-housing.stl]
2026-07-22 Document OLED, LED ring, switch, and encoder wiring
    - OLED: SDA/SCL join the shared I2C bus, VCC/GND connections.
    - LED ring: only the input triad (DIN/5V/GND) is needed, not all 6
    breakout pads -- the other triad is for daisy-chaining a second
    ring/strip this build doesn't have. Note the 3.3V-GPIO-driving-5V-chain
    logic-level caveat and its usual symptom/fix.
    - EC11 encoders and the 3-way rocker: continuity-based method for
    identifying Common/switch-leg pins when the physical layout isn't
    obviously labeled, since it varies by manufacturer.
2026-07-22 Add WS2812 LED ring bring-up test
    Solid red/green/blue/white fills (catches a wrong GRB/RGB pixel-order
    default) followed by a one-at-a-time walk across all 7 pixels (catches
    a dead/miswired individual LED). Needs sudo for PWM/DMA access, unlike
    the plain-gpiozero scripts elsewhere in testing/. Turns the ring off on
    exit rather than leaving it lit.
    [led_ring_test.py]
2026-07-22 Document confirmed Jewel-style ring + planned interior backlighting strip
    - BOM/gpio-pin-assignments: ring is Jewel-style (6 outer + 1 center),
    confirmed via bring-up test -- chain walks the outer 6 then lights
    center last.
    - Plan an interior NeoPixel strip for whole-case backlighting through
    unit #1's translucent PLA shell, chained off the ring's spare OUT
    triad (same GPIO12 line, no new GPIO). Logged in decision-log.md,
    BOM'd as planned/not-yet-sourced, noted as a power-budget item to
    recheck once a length is picked.
    - feature-spec/open-questions: interior strip as a second lighting
    channel for Simon/Tutor mode feedback, exact behavior still open.
2026-07-22 Add flat/natural/sharp rocker switch bring-up test
    Reports FLAT/NATURAL/SHARP on every change; flags if flat and sharp
    ever read active simultaneously, since that's a wiring problem (not a
    real position) on this single-pole switch.
    [rocker_test.py]
2026-07-22 Add SSD1306 OLED bring-up test
    Border rectangle + text to confirm the panel is actually alive (not
    just I2C-detected), then a full-panel invert flash to check every
    pixel independent of the drawing code, then clears.
    [oled_test.py]
2026-07-22 Fix oled_test.py: use Pillow instead of framebuf's .text()
    adafruit_framebuf's built-in .text() needs a separate font5x8.bin
    bitmap file that pip doesn't bundle -- fails with a bare
    FileNotFoundError on a fresh install. Pillow's default font avoids the
    extra asset dependency, and is the more standard approach for
    SSD1306-over-Blinka anyway.
    [oled_test.py]
2026-07-22 Fix ads1115_test.py: ADS.P0/P1 constants don't exist in library 3.0.5
    A fresh pip install currently pulls adafruit-circuitpython-ads1x15
    3.0.5, which dropped the old ADS.P0/P1 named constants in favor of
    plain integers 0-3 for AnalogIn's positive_pin. hardware_poller.py
    uses the old ADS.P0/P1 spelling and would hit the same AttributeError
    if actually run against this version -- noted in the docstring.
    [ads1115_test.py]
2026-07-22 Temporarily disable joystick channel in ads1115_test.py -- not wired yet, just clutters pot-only checks
2026-07-22 Note pot's inverted voltage-to-volume direction, confirmed via bring-up test
2026-07-22 Re-enable joystick channel in ads1115_test.py -- now wired
2026-07-22 Add EC11 rotary encoder bring-up test (octave/font)
    Uses gpiozero's RotaryEncoder for quadrature decoding/debouncing.
    Reports CW/CCW clicks and button presses live, with a summary count on
    exit -- turning through known detent counts in each direction should
    match what's reported, confirming no double-counts or skips.
    [encoder_test.py]
2026-07-23 Document speaker-vs-shelf clearance bug found on unit #1
    hardware_cutouts() only cuts the speaker grille opening, never modeled
    the physical speaker's depth against the shelf's right-side components
    (joystick especially, at shelf x=-65, most outboard on that side).
    Unit #1 shipped with the speaker trimmed by hand (deadline fix, not a
    CAD change) -- next print needs a real depth measurement and an actual
    geometry fix, logged as an open question.
2026-07-23 Add FluidSynth smoke test, staged for when the Pi's back online
    Untested as of this commit -- ChromaCade's Pi was powered off, so this
    is written and syntax-checked only, ready to pull and run the moment
    it's back. Informed by nektar-synth (separate project) already running
    fluidsynth + FluidR3_GM.sf2 successfully on identical Pi Zero 2W
    hardware, which resolves the main feasibility risk before any of this
    touches the real audio engine. Logged as an explicitly-deferred
    open question in open-questions.md -- not starting real integration
    before the Saturday deadline.
    [fluidsynth_test.py]
2026-07-23 Gitignore downloaded audio assets and their fetch script
    Third-party copyrighted sound clips (for a planned boot notification
    chime) do not belong in this public repo, nor does the script that
    fetches them. Both stay local-only on-device.
2026-07-24 Fix fluidsynth_test.py: sfload() failure isn't an exception, it's -1
    Found this the hard way -- a missing soundfont file caused fluidsynth's
    own C-level error logging to print, but pyfluidsynth's sfload() just
    returned -1 rather than raising, so the try/except never fired and the
    script happily printed "Done" after a real load failure.
    [fluidsynth_test.py]
2026-07-24 Fix fluidsynth_test.py: default gain too quiet, add --gain
    pyfluidsynth's synth.gain default (0.2) is much quieter than
    nektar-synth's proven `-g 3.0` command-line flag -- the equivalent
    Python setting was simply missing. Confirmed on real hardware: default
    produced a "very brief and quiet" note; added --gain (default 3.0,
    matching nektar-synth) as the fix.
    [fluidsynth_test.py]
2026-07-24 Add boot-ready chime script and systemd unit
    Plays OOT_Navi_Hello1.wav once at boot (5s delay for audio hardware
    init, matching nektar-synth's margin) to signal the device has
    finished starting up. The wav itself stays gitignored/local-only; this
    is just the script + unit that reference it.
2026-07-24 Lock in interior strip LED count: 16 (23 total with the ring)
    Chosen 2026-07-24, comfortably within the ~25-LED power budget at
    brightness 0.3 computed earlier -- no need to redo that math. Also
    noted: ring+strip share one WS2812 chain but remain individually
    addressable per-pixel, so the planned "alternate, never simultaneous"
    behavior is a UX choice, not a wiring constraint.
2026-07-24 Add pinout to the gpio-pin-assignments.md
2026-07-25 Extend led_ring_test.py to the full 23-pixel ring+strip chain
    Defaults to 23 (7-pixel ring + 16-pixel strip), with --num-pixels to
    override (e.g. 7 to test just the ring before the strip is wired).
    Walk test now labels which pixel index belongs to the ring vs. the
    strip when running the full chain.
2026-07-25 Bump audio_test.py default --seconds 1.5 -> 15 for bench multimeter tests
    Longer window needed to get a probe positioned and read a fluctuating
    meter during AC-voltage-while-playing style tests.
2026-07-29 Fix ads1115_test.py raw/voltage mismatch: two separate I2C reads per line
    .voltage and .value were each triggering their own ADC conversion, so
    the printed pair could reflect two different samples (e.g. raw=5060
    paired with voltage=-0.015V). Read .value once and derive voltage from
    the same sample instead.
    [ads1115_test.py]
2026-07-29 Log joystick and octave-encoder click buttons as open questions
    Both parts have a built-in push-button that's wired (joystick isn't
    wired at all yet; octave encoder's is on GPIO13) but never assigned a
    function in any design doc -- unlike deliberately-rejected ideas
    elsewhere in the project, these were just never surfaced.
2026-07-29 Split LED ring/strip into independent GPIO12/GPIO13 chains; remove 2nd amp
    Ring/strip combined chain kept showing color corruption even after
    resoldering the ring's DIN joint, so they're no longer chained
    ring-OUT -> strip-IN on one GPIO12 line. Strip gets its own DIN on
    GPIO13 (PWM1, a separate hardware channel), freed by moving the octave
    encoder's push-button to GPIO25 -- that click has no assigned function
    yet anyway. Splitting isolates whether the ring, the strip, or both
    have the actual signal-integrity problem, and shortens each run.
    led_ring_test.py rewritten around two independent NeoPixel objects;
    --target ring|strip|both replaces the old --num-pixels combined-chain
    override.
    Als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
    [led_ring_test.py]
2026-07-29 Mark LED ring/strip level-shifter question resolved
    Both ring and strip confirmed working driven directly (no level
    shifter) once split onto independent GPIO12/GPIO13 chains. The
    combined 23-pixel chain's corruption was a chain-length issue, not a
    ring-specific defect.
2026-07-29 Octave encoder push-button confirmed dead; font encoder's is now sole click control
    Rotation/quadrature still works fine, only the built-in click switch
    failed. That click never had an assigned function to begin with, so
    this closes the open question rather than blocking anything -- font
    encoder's push-button remains the only working click control on the
    build. Abandoned rather than repaired; GPIO25 stays wired to the dead
    switch until/unless that leg is desoldered.
2026-07-29 Document joystick axis inversion (confirmed via bring-up test)
    Pushing forward decreases voltage, pulling back increases it, but
    desired pitch-bend behavior is forward=sharp, back=flat. As-wired, not
    worth re-wiring for -- future pitch-bend code should invert around
    center (center_voltage - voltage), same shape of gotcha as the
    existing A1 volume-pot inversion note.
2026-07-29 Add note_buttons_test.py for the real 7-button panel
    key_test.py/note_test.py only ever covered the 3-key test mount
    (GPIO14/15/25), not the final note-button pins. This targets the
    actual A-G assignments from gpio-pin-assignments.md (GPIO4/17/27/22/
    10/9/11) with the same press/release/chord-count pattern as key_test.py.
2026-07-29 Reopen octave push-button diagnosis pending a clean-pin retest
    GPIO25 (physical pin 22) was previously soldered, then desoldered, for
    the now-disassembled 3-key test mount's "Key 3" -- that solder/
    desolder history on GPIO25's pad is a plausible fault on its own,
    independent of whether the octave switch is actually dead. Before
    finalizing "confirmed dead," retest on GPIO7 or GPIO8 (the only spares
    with zero prior solder history -- GPIO14/15 were also part of the same
    test mount).
2026-08-13 Disable onboard PWM audio: was conflicting with WS2812 GPIO12/13
    dtparam=audio=on claims the same PWM0/PWM1 peripheral the LED ring
    and strip use for data, and this build's real audio path is entirely
    I2S -- the onboard analog path was unused. Set dtparam=audio=off on
    the board and rebooted; likely fix for a rhythmic stutter noticed
    during amp rewiring, pending a live audio+LED retest to confirm.
2026-08-13 Add image and short video of the device
2026-08-13 Remove key_test.py: fully superseded by note_buttons_test.py
    3-key test mount is disassembled and the real 7-button panel test
    covers everything it did (plus B-G). Updated the two references that
    pointed at it (rocker_test.py's convention note, note_buttons_test.py's
    docstring) and CLAUDE.md's example tooling list. Left the 2026-07-20
    test-plan doc alone since it's a historical record of a session where
    key_test.py genuinely was the tool in use.
2026-08-13 Document WM8960 HAT's onboard button sharing GPIO17 with Note B
    Confirmed via note_buttons_test.py: pressing the WM8960's own tactile
    button registers as a B press. Harmless (parallel switches, no driver
    involvement), but worth flagging given how tight the enclosure is --
    an accidental knock against the HAT during assembly would look like a
    phantom B press.
2026-08-14 Log FluidSynth/dmix latency finding in open-questions.md
    ~125ms through the dmix default PCM, plus no rtprio grant for the
    playback thread. Fine for background melody testing tonight, but
    flagged since it matters once this is real button-press-to-sound
    latency rather than terminal-triggered playback.
2026-08-14 Log unit #1's temporary micro-USB power for bring-up
    Skipping the LiPo/boost board for now -- cable through the back panel
    hole, secured against strain, supervised tabletop use only. Not a
    reversal of the battery decision, just a bring-up simplification.
2026-08-14 Fix stale octave button pin in encoder_test.py, add --button-pin override
    Script still had GPIO13 hardcoded for the octave button -- that pin
    belongs to the LED strip now (moved 2026-07-28). Corrected default to
    GPIO25 to match current docs, and added --button-pin so the pending
    GPIO7/8 retest doesn't need another edit.
    [encoder_test.py]
2026-08-15 Octave push-button confirmed alive on GPIO8, reverse "dead switch" call
    Retest (GPIO7/8 plan from last night) came back clean on GPIO8 via
    encoder_test.py. Switch was never broken -- GPIO25's pad had solder
    history from the old 3-key test mount and was the actual fault.
    Updated gpio-pin-assignments.md (pin table, GPIO budget), decision-log
    (reversed the "confirmed dead" entry), and open-questions (the click's
    function is a live question again now that the hardware works).
2026-08-15 Document octave encoder rotation direction inversion
    Confirmed via encoder_test.py: physical CW reads as CCW and vice
    versa. Same as-wired-not-worth-rewiring pattern as the volume pot and
    joystick axis inversions -- invert in software when mapping steps to
    octave changes.
2026-08-15 Font encoder fully wired: button moved off dead-end GPIO20 to GPIO7
    GPIO20 is permanently claimed by I2S (ALT0/PCM_DIN) on this build --
    the font button could never have registered there. Moved to GPIO7,
    confirmed working (rotation + button). Also documented the same
    CW/CCW-inverted-as-wired situation as the octave encoder, and
    corrected the GPIO budget: GPIO20 was never actually usable, pulled
    out of both the used and spare counts.
2026-08-15 Log enclosure cable-management concern from tonight's assembly
    Raised during wiring, not just a future access question -- the case
    is cramped enough to make in-place screw-terminal connections
    difficult and forces longer wire runs than necessary. Deferred pending
    whether unit #1's hardware works end-to-end first.
2026-08-15 Lock in note range: 7 octaves, C0-C8, confirmed via live speaker sweep
    Tested end-to-end on the actual WM8960/speaker hardware (whole-tone
    then chromatic sweeps, both directions from A4/C4). All 7 octaves
    sound acceptable; below C0 gets duller but not broken. Also: octave
    grouping should be C-B (standard convention), not alphabetical A-G --
    firmware mapping only, keycaps are color-coded not letter-printed.
    Flagged the real headroom requirement for flat/sharp/pitch-bend at
    the range edges, and logged the still-open bend-semitone-budget
    question.
2026-08-15 Clarify: skip per-instrument range testing, but still want loudness parity
    Not forcing every instrument across the full 8 octaves doesn't mean
    ignoring the loudness gap between voices -- switching fonts shouldn't
    jump volume just because GM patches aren't mixed to a common level.
    Needs a per-instrument gain table in the eventual audio engine.
2026-08-15 Resolve letter-to-keycap-color assignment: C-D-E-F-G-A-B, measured hex
    Physical buttons run C through B left to right (matching the C-to-B
    octave convention), not alphabetical A-G. Hex values measured directly
    from unit #1's photographed keycaps rather than guessed from listing
    photos. Hue-arc compression and chord-blend validation are still open
    separately -- this is a real input to that work, not a substitute.
2026-08-15 Resolve LED ring color assignment via live hardware tuning
    Tuned bold RGB values on unit #1's actual WS2812 ring rather than
    reusing the keycap hex directly -- pastel keycap values read as
    washed-out white when emitted as light instead of reflected. Confirmed
    the resulting 7-letter set progresses monotonically around the hue
    wheel with a small B->C wrap gap, validating the letters form a
    coherent rainbow as a set (separate from, and doesn't resolve, the
    still-open chord-blend hue-arc-compression question).
2026-08-15 Relabel note buttons C-D-E-F-G-A-B, confirmed via live test
    Same GPIO pins (4,17,27,22,10,9,11), same physical buttons -- only the
    letter labels change, to match the C-to-B octave convention decided
    tonight. Confirmed by pressing all 7 strictly left-to-right and
    reading back which GPIO fired in which order.
2026-08-15 Add first real firmware slice: buttons -> FluidSynth piano (C4 octave)
    audio_engine.py: pure, pytest-covered note math (midi_note(), already
    plumbed for octave/accidental even though only C4-natural is wired up
    yet) plus a thin FluidSynth wrapper. hardware_poller.py: gpiozero-based
    GPIO polling, note buttons only for now, structured to extend with the
    encoders/rocker/joystick/pot as their own items land. play.py ties
    them together into something actually playable.
    Not built on Brian's closed brian/core-audio-engine stub -- reused its
    pin layout and callback-dict shape, but it's pygame/sine-wave based
    (exactly what needs replacing) and has stale octave/font button pins
    plus the known ADS.P0/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
2026-08-15 Fix play.py: HardwarePoller wasn't kept referenced, buttons went dead
    Unreferenced HardwarePoller got garbage collected almost immediately
    after construction, taking its gpiozero Button objects (and their GPIO
    pin claims) with it -- buttons stopped listening within a fraction of
    a second, silently, no error. Also added PRESS/release print feedback
    so this class of bug is visible immediately instead of just "no
    sound" with no clue why.
    [play.py]
2026-08-15 Wire LED ring into play.py: shows most-recent held note's color
    New led_ring.py holds the tuned NOTE_COLORS (from tonight's live ring
    testing) and a thin NeoPixel wrapper. play.py now lights the ring on
    note_on, clears on release with nothing held. Placeholder behavior for
    multi-note chords (most-recent-held wins) -- real chord-blend logic is
    deferred, see feature-spec.md. play.py now needs sudo for the ring's
    PWM/DMA access, same as led_ring_test.py.
2026-08-15 Document sudo-pip-install convention for root/user package parity
    Found running play.py: pyfluidsynth and two adafruit-circuitpython
    libs were installed for the user but not root, breaking sudo (needed
    for the LED ring's PWM/DMA access). Fixed by installing all three for
    root too; documented the standing convention (always sudo pip install
    --break-system-packages for pip-only deps) so it doesn't recur as more
    packages get added.
2026-08-15 Wire octave encoder into play.py, debounced to one octave per gesture
    octave_gesture.py: pure, pytest-covered debounce -- any burst of
    same-direction clicks resolves to exactly +-1 octave once rotation
    pauses, not one octave per click. Fixes two real problems: the EC11
    free-spins with no end-stops (a fast spin shouldn't jump 6 octaves),
    and single-click precision isn't realistic for a toddler. Direction
    reversal mid-gesture restarts it rather than netting out.
    audio_engine.py: octave_change() re-triggers currently-held notes at
    the new octave (feature-spec.md already specifies octave applies
    globally to whatever's held, not just future presses) -- pitch audibly
    shifts under a held finger, w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
    [audio_engine.py, hardware_poller.py, octave_gesture.py, play.py, test_audio_engine.py, test_octave_gesture.py]
2026-08-15 Flip octave gesture debounce from trailing-edge to leading-edge
    Fixes the perceived lag reported after live testing: previously waited
    for a pause before committing an octave step, so every turn had a
    ~400ms delay before anything happened. Now the first click of a
    gesture fires immediately and further clicks in the same burst are
    absorbed instead -- same protection against a fast spin jumping
    multiple octaves, zero perceived lag. OCTAVE_GESTURE_PAUSE now only
    gates how long a gesture stays "active" absorbing clicks, not
    responsiveness.
    [hardware_poller.py, octave_gesture.py, test_octave_gesture.py]
2026-08-15 Wire flat/sharp rocker into play.py, retriggers held notes live
    audio_engine.py: rocker_accidental() maps the rocker's raw (flat,
    sharp) throw pair to an accidental value, pure and tested -- both
    throws active at once is a wiring fault (see testing/rocker_test.py),
    falls back to natural rather than raising since it needs to be
    callback-safe. Refactored octave_change()/accidental_change() to share
    a _retrigger_held() helper -- both apply globally to whatever's held
    (feature-spec.md), same pattern, no reason to duplicate the retrigger
    loop.
    hardware_poller.py: wires the rocker's two Button objects exactly like
    testing/rocker_test.py's already-proven pattern (both throws' press
    and release re-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
2026-08-15 Wire pitch-bend joystick into play.py, +-0.5 semitone starting range
    audio_engine.py: joystick_bend_fraction() (voltage -> -1.0..1.0,
    inverted per the confirmed wiring) and pitch_bend_value() (normalized
    bend -> the raw value Synth.pitch_bend() expects), both pure and
    tested. Checked the actual installed pyfluidsynth's pitch_bend()
    docstring rather than assume the API -- 2048 units/semitone, +-4
    semitone max range, not the +-2 semitones I'd have guessed. Bend range
    starts at +-0.5 semitones (approaches but never reaches the
    neighboring sharp/flat) per tonight's plan, tunable via
    MAX_BEND_SEMITONES.
    set_pitch_bend() needs no retrigger logic -- MIDI pitch bend is
    inherently channel-wide, so i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
    [audio_engine.py, hardware_poller.py, play.py, test_audio_engine.py]
2026-08-15 Bend range to +-4 semitones, max velocity, color crosses to neighbor
    MAX_BEND_SEMITONES 0.5 -> 4.0 to test the full range pyfluidsynth
    supports. NOTE_VELOCITY bumped to max (127) -- no expressiveness lost
    since there's no velocity-sensing input on this build, and it's worth
    testing whether it helps the piano patch's natural decay ring out
    longer (may just be authentic to how the sample was recorded, not
    fixable this way -- noted in the comment).
    bent_letter(): pure, tested function computing which letter a bent
    note is now closer to, crossing at the halfway point to the neighbor.
    E-F and B-C are the diatonic scale's two half-steps (1 semitone, vs 2
    for every other adjacent pair), so they cr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
    [audio_engine.py, play.py, test_audio_engine.py]
2026-08-15 Fix bent_letter() to handle multi-boundary bends, not just one hop
    Real bug, caught live: at the new +-4 semitone range, a large enough
    bend can cross more than one letter boundary (G bent up a full 4
    semitones lands exactly on B's pitch, past A), but the old
    single-neighbor-check implementation would stop at A and never notice.
    Rewrote to compare the actual bent pitch against all 7 letters by
    circular distance and pick the nearest, with ties breaking toward the
    neighbor (matching the old >=halfway rule) rather than staying home.
    Added tests for the exact G->A->B scenario and the halfway-through
    case (G+2 semitones lands exactly on A).
    [audio_engine.py, test_audio_engine.py]
2026-08-15 Smooth joystick reading + bump poll rate, felt jumpy on live testing
    audio_engine.py: smooth(), a small pure/tested exponential moving
    average. hardware_poller.py: applies it to the raw voltage reading
    before computing bend, plus bumped JOYSTICK_POLL_INTERVAL 30Hz -> 50Hz.
    Both tunable (JOYSTICK_SMOOTHING_ALPHA, JOYSTICK_POLL_INTERVAL) --
    starting guesses, not final values.
2026-08-15 Wire volume pot into play.py, capped at 70% via a safety ceiling
    audio_engine.py: pot_volume_fraction() (voltage -> 0.0-1.0, inverted
    per the confirmed wiring) and volume_midi_value() (normalized volume
    -> the 0-127 value Synth.cc(chan, 7, val) expects, scaled by
    VOLUME_CEILING). Checked the actual installed pyfluidsynth's cc()
    docstring first -- confirms CC7 is standard MIDI channel volume.
    set_volume() needs no retrigger logic, same channel-wide reasoning as
    set_pitch_bend().
    VOLUME_CEILING=0.7 implements feature-spec.md's "even at max pot
    position, output should never exceed a level appropriate for a small
    room" requirement -- a real number for a requirement that's existed as
    a descripti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
    [audio_engine.py, hardware_poller.py, play.py, test_audio_engine.py]
2026-08-15 Add gamma curve to volume mapping, fixes silent lower-2/3 pot range
    Confirmed live: a straight linear pot->MIDI-CC7 mapping left the
    machine silent through roughly the lower two-thirds of the pot's
    travel, only audible near the top -- perceived loudness is roughly
    logarithmic, so a linear control crams most of the audible range into
    a small slice of rotation. VOLUME_CURVE_GAMMA=0.5 (square root) gives
    low pot positions relatively more MIDI headroom than linear would.
    Preserves the 0.0/1.0 endpoints exactly regardless of gamma. Starting
    guess, tune live.
    [audio_engine.py, test_audio_engine.py]
2026-08-15 Make Church Organ the real committed default, not a throwaway test
    Was doing this as a board-only, never-committed sed edit each time we
    wanted to test with a sustained voice. User's call: since font
    switching will replace any fixed default anyway once it lands, and
    organ is genuinely a better voice for testing every other control in
    the meantime (no decay to muddy pitch-bend/volume evaluation), just
    commit it as DEFAULT_PROGRAM rather than keep re-doing the temporary
    edit. Piano's still one program_select() call away, nothing lost.
    [audio_engine.py, play.py]
2026-08-15 Wire font encoder into play.py, curated 11-voice list
    audio_engine.py: FONTS (GM program + OLED display name pairs, from
    tonight's live listening tests -- Organ, Piano, Toy Piano/Celesta,
    Ocarina, Steel Drums, Melodic Tom, Violin, Overdrive, Xylophone,
    Glockenspiel, Synth). font_index_change() is pure/tested wraparound
    cycling -- no debounce/gesture batching needed unlike the octave
    encoder, since there's no "home" position to get lost from by
    overspinning a discrete list. ChromaCadeAudio.font_change() resolves a
    previously-open question (does changing font mid-note retrigger the
    held note?) -- yes, same instructive/delightful pattern as
    octave/accidental, reuses _retrigger_held().
    hardware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
    [audio_engine.py, hardware_poller.py, play.py, test_audio_engine.py]
2026-08-15 Fix segfault on Ctrl+C: stop background thread before freeing FluidSynth
    Confirmed live 2026-08-15. The ADS1115 polling thread runs continuously
    calling into FluidSynth (pitch_bend/cc); on Ctrl+C, play.py's finally
    block called audio.quit() -> fs.delete() with nothing stopping that
    thread first. If it was mid-call into FluidSynth when the underlying
    C object got freed, that's a use-after-free -- segfaults the process
    instead of raising a catchable error. Same risk for a pending
    octave-gesture timer.
    HardwarePoller.stop() now cancels any pending timer, signals the poll
    thread via a threading.Event, and joins it -- blocks until background
    activity has actually stopped, not just signaled to st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
    [hardware_poller.py, play.py]
2026-08-15 Fix false "bend crossed" messages when a second note is pressed
    Confirmed live 2026-08-15: holding a chord (pressing a second note
    while the first is still held) printed misleading "COLOR X -> Y (bend
    crossed the halfway point)" messages, because update_ring() only
    checked whether the displayed letter changed, not why. The ring always
    shows held[-1] (the placeholder "most recent note" chord behavior), so
    pressing a new note legitimately changes the display too -- that's not
    a bend event. Now tracks the underlying held note (not just the
    displayed letter) so the message only fires when the same held note's
    bent identity actually shifts, not whenever a press/release swaps
    which note is shown.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
    [play.py]
2026-08-15 Back panel: power cable passthrough, remove switch cutout, add fan vent
    Removes the old USB-C charge-port cutout and separate power-switch
    cutout -- unit #1 is skipping the LiPo/DWEII boost-charge board for
    now, powering via a micro-USB cable routed straight through the back
    panel instead (see decision-log.md's Power section), and that cable
    has its own inline switch so no panel switch cutout is needed.
    Power cable hole: 4mm dia, measured against the actual cable (just
    over 3mm).
    Fan vent: 39mm square fan, 32mm x 32mm M3 mounting holes, both
    measured directly against the actual fan. Grille reuses the housing's
    stadium_hex_grill module (copied, not shared/included, matching this
    project's s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
    [chromacade-back-panel.scad]
2026-08-15 Adjust power cable hole position in SCAD file
    Moved hole to trap cable better.
    [chromacade-back-panel.scad]
2026-08-15 Add Tutor mode: demo playthrough + color-matching game
    Two phases per feature-spec.md's Tutor/follow-along sub-mode:
    1. tutor_mode.py's play_demo() plays a song once through
    ChromaCadeAudio with the LED ring cueing each note's color
    (console print stands in for the not-yet-wired OLED).
    2. TutorSession (tutor_songs.py) then cues each note and waits for a
    matching button press before advancing, no penalty on a miss.
    tutor_songs.py's SCORES is the single source of truth (note name +
    octave + duration, same "C4"/"F#5" convention as
    audio/play_melody.py); SONGS (bare letters for the matching game) is
    derived from it rather than hand-duplicated. Matching is letter-only
    by design, not jus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
2026-08-15 Tutor mode: use Toy Piano instead of Organ
    Organ has no decay, so back-to-back same-pitch notes with no gap (e.g.
    Hot Cross Buns' "C C C C" run) blend into one continuous held tone
    instead of sounding like distinct repeated presses. Toy Piano's
    percussive attack/decay keeps repeats audibly separate. Confirmed live
    2026-08-15. Scoped to tutor_mode.py only, play.py's default is unchanged.
2026-08-15 Tutor mode: celebration flash on song completion, then clean exit
    - led_strip.py: first real (non-test) use of the interior 16-LED
    strip (GPIO13) -- a minimal LedStrip mirroring LedRing's shape
    (fill/clear). Long-term strip behavior is still undesigned (see
    open-questions.md), this is just the fill/clear primitive.
    - led_ring.py: adds fill(color) so callers can push arbitrary colors,
    not just NOTE_COLORS letters; show()/clear() now delegate to it.
    - tutor_mode.py: on song completion, flashes the ring+strip together
    through a few colors ("you did it!"), then exits on its own instead
    of sitting in pause() waiting for Ctrl+C. There's no menu/game UI
    layer yet to hand control back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
2026-08-15 Tutor mode: strip flashes red + plays nope.wav on a wrong key
    Ring is deliberately untouched by a miss -- it's the persistent target
    cue (feature-spec.md's "gently don't advance, keep the current note's
    cue lit"), so it should hold steady through a wrong press rather than
    react to it. All the wrong-key feedback lives on the strip instead:
    red flash + nope.wav together, then a flash of the correct color as a
    "here's what you want" reminder.
    nope.wav plays via plain `aplay` (default/dmix PCM), not
    boot_chime.sh's `-D plughw:1,0` -- ChromaCadeAudio holds the dmix-
    backed default device open for the script's whole life, and dmix is
    specifically what lets a second process share it concurrently;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
    [tutor_mode.py]
2026-08-16 Fix nope.wav silently not playing: sudo resets HOME, breaks ~ expansion
    os.path.expanduser("~/ChromaCade/nope.wav") resolved to
    /root/ChromaCade/nope.wav under sudo (confirmed live), not
    /home/shane/ChromaCade/nope.wav -- the miss-flash ran fine but no
    sound, since aplay silently failed to find the file (stderr was
    suppressed). Hardcode the absolute path instead, same convention
    boot_chime.sh already uses for the same reason. Also stop suppressing
    aplay's stderr, since suppressing it is exactly what hid this bug.
    [tutor_mode.py]
2026-08-16 Add unified app: OLED display + menu/mode-switching + song selection
    chromacade.py is the new real entry point -- one persistent process
    (ChromaCadeAudio/HardwarePoller/LedRing/LedStrip/OledDisplay all built
    once, never torn down) replacing manually running play.py or
    tutor_mode.py --song X separately. A top-level app["state"] ("play" |
    "menu" | "tutor_demo" | "tutor_active") dispatches the same poller
    callbacks differently depending on mode. play.py/tutor_mode.py are
    left in place as standalone dev tools, not deleted; tutor_mode.py's
    play_demo()/celebrate()/miss_feedback()/TUTOR_PROGRAM are imported and
    reused directly rather than duplicated.
    New pieces:
    - menu.py: pure, hardware-free nest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
2026-08-16 Fix stuck sustained note when the menu gesture fires
    B (or C) always plays on press, before it's known to be part of a
    gesture -- if the state flips to "menu" mid-hold, the eventual release
    lands in a state where note_off() is a deliberate no-op ("menu owns
    input"), so that note_off call never happens. Left the note stuck
    sustaining, and left it in chromacade.py's `held` list too. Confirmed
    live 2026-08-15.
    Fix: ChromaCadeAudio.all_notes_off() (also de-dupes quit()'s identical
    inline loop) called from menu_enter(), plus clearing `held` and the
    ring's shown/shown_base tracking there -- covers a whole chord, not
    just the gesture's own note. Also added to stop_active_tutor() for the
    same reaso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
    [audio_engine.py, chromacade.py]
2026-08-16 Fix song list truncated on the OLED: scroll instead of assuming it fits
    display_lines() returned every song unconditionally -- fine for the
    2-item mode list, but 5 songs + a header line is 6 lines and the OLED
    only renders 5 (HEIGHT // LINE_HEIGHT), so the last song (Frere
    Jacques) silently never appeared. Looked exactly like a missing song
    rather than a display bug.
    Now scrolls to keep the highlighted item in view once the list
    outgrows max_lines (default 5, matching oled_display.py's actual
    capacity). Mode-select is unaffected (only 2 items, always fits).
    4 new regression tests, including one that walks every real song in
    tutor_songs.SONGS and confirms each is visible when highlighted.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
    [menu.py, test_menu.py]
2026-08-16 Tune C's LED color: small blue tint so it reads more distinctly red
    Flagged live 2026-08-15: C and D were hard to tell apart without a
    direct side-by-side comparison. C was already RGB-maximal red
    (255,0,0), so there's no "more red" to add on that channel -- a small
    blue component instead, cooling it toward true scarlet/crimson rather
    than the warmer orange-red WS2812 red channels tend to skew toward on
    their own.
2026-08-16 Add Simon Says mode: growing memory sequence, 3 sequence sources
    Classic escalating-sequence memory game (feature-spec.md's Simon/Learn
    mode, second sub-mode) -- watch a growing sequence, reproduce it from
    memory, wrong press resets (unlike Tutor's no-penalty design; the doc
    explicitly leans toward Simon resetting since it's meant to test, not
    teach).
    Three sequence sources, all requested by the user tonight:
    - Random: classic Simon, a fresh random letter appended each round,
    never ends.
    - A famous number: digits mapped to letters mod 7 (0=C...6=B, wraps),
    e.g. pi's "3.14159" -> F D G D A E. Pi/e/Golden Ratio bundled.
    - An existing Tutor song: its real note sequence, revealed
    incremen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
    [chromacade.py, menu.py, simon_sequences.py, test_menu.py, test_simon_sequences.py]
2026-08-16 Revert C's blue tint (read as pink instead), push D toward true orange
    Blue tint on C overcorrected -- flagged live as too close to B/pink.
    Reverted C to pure (255,0,0) and fixed the original C/D confusion from
    the other side: D was only 18% green (255,45,0), barely past red,
    closer to "red-orange" than a clear orange. Bumped to 100/255 (~39%),
    roughly the midpoint between C's 0 and E's 170 (yellow-orange).
    [led_ring.py]
2026-08-16 Simon: light ring on key presses, 1s pause between rounds, richer miss cue
    Three changes requested 2026-08-15:
    - Ring now lights on each press during simon_active (press feedback,
    matching Play/Tutor), clearing on release. Guarded by re-checking
    app["state"] at the actual moment note_off() runs (not when the
    physical release happened) -- if that's delayed behind a blocking
    play_simon_round() triggered by the same press, state will already
    have moved to "simon_demo" by then, so the clear is skipped instead
    of clobbering the next round's demo animation.
    - 1s pause (SIMON_ROUND_COMPLETE_DELAY_SECONDS) after completing a
    round correctly, before the next round's playback starts.
    - s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
    [chromacade.py]
2026-08-16 Fix gitignore for the zelda/ reorg, track yays/nopes recordings
    User moved the Zelda Navi clips into audio/zelda/ and wants
    audio/yays/ and audio/nopes/ (Tutor/Simon feedback recordings)
    committed, not gitignored -- those are personal recordings, not
    copyrighted third-party content like the Navi clips. Replaced the old
    flat audio/*.wav rule (which matched nothing now that everything moved
    into zelda/) with audio/zelda/, reverted the audio/yays//audio/nopes/
    ignore rules added earlier tonight, and left an explicit "don't add a
    blanket wav rule here" note since it's easy to reintroduce by
    accident.
    Also fixes a real breakage from the same move: boot_chime.sh still
    pointed at the old flat audi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
2026-08-16 Wire up the yays/nopes sound pools; fix Tutor still playing dead nope.wav
    Root cause of the reported bug: sound_pools.py (the Cycler + pool-
    building logic for the 11 recorded sounds) was designed but never
    actually written/wired in -- got interrupted partway through by a
    volume-tuning detour. tutor_mode.py's miss_feedback()/celebrate() were
    still calling the old single-file play_nope_sound() (superseded, dead
    code at this point), so Tutor kept playing the old root-level
    nope.wav regardless of the new audio/nopes/ pool existing.
    sound_pools.py: Cycler (pure/testable) + build_pools(), returning 4
    cyclers built from what's actually in audio/nopes//audio/yays/:
    - tutor_error: any nopes/ file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
    [chromacade.py, sound_pools.py, test_sound_pools.py, tutor_mode.py]
2026-08-16 Fix real heap corruption crash: lock all FluidSynth access
    Confirmed live 2026-08-16 during heavy rapid button-mashing + back-to-
    back font changes: "free(): invalid next size (fast)", a genuine
    native heap corruption crash, not a Python exception. Root cause:
    FluidSynth's C API isn't guaranteed safe for concurrent calls from
    multiple threads, and this project calls into it from at least three --
    gpiozero's button/encoder callback path, hardware_poller.py's
    dedicated ADS1115 polling thread (~50Hz continuously, unconditionally,
    whether or not the joystick/pot are actually moving), and any blocking
    sequence (celebrate()/play_demo()/etc) running inside one of those
    callback threads. The earlier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
    [audio_engine.py]
2026-08-16 Add systemd service for chromacade.py, running as the real app now
    Ships to the kids' house today -- needs to boot straight into the
    instrument, no SSH required. Runs as root (LED ring/strip PWM/DMA
    needs it, same as every manual sudo python3 chromacade.py invocation
    tonight). Restart=on-failure + a 3s delay as a safety net specifically
    because a real crash was found and fixed this same session -- that
    bug's fixed, but nobody will be able to SSH in or power-cycle it once
    it's there, so turning any future crash into a ~3s hiccup instead of a
    dead instrument seemed worth it. StartLimitBurst caps runaway
    crash-looping at 5/60s rather than hiding a truly broken state.
2026-08-16 Populate parental web page: full controls/modes guide, rename Play->Explore
    Real content now (requested 2026-08-16): Explore mode's controls
    (note buttons + color legend, rocker, octave encoder, font encoder +
    current voice list, pitch-bend joystick, volume knob, OLED readout),
    the menu entry/exit gesture, and full explanations of Tutor and Simon
    mode (including Simon's three sequence sources and that Tutor songs
    automatically become Simon sources too). All facts pulled directly
    from the running code (FONTS, MAX_BEND_SEMITONES, NOTE_COLORS, the
    hardware_poller.py gesture constants) rather than written from memory
    -- color hex values in the page independently verified against
    led_ring.NOTE_CO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
2026-08-16 Add Power User Notes section to the parental web page
    Requested 2026-08-16: pointer to Raspberry Pi Connect for remote
    access, the public GitHub repo, and instructions for pointing an AI
    coding agent (Claude Code or otherwise) at the repo's CLAUDE.md to get
    oriented -- clone + start the agent from inside the directory, no
    special flag needed since Claude Code and similar tools auto-read
    CLAUDE.md as context. Also noted the deploy mechanism (git pull +
    systemctl restart chromacade.service) since the app runs as a service
    now, not a manually-launched script.
2026-08-16 Add Power Off/Reboot menu options, support links, defer overlay-fs to next build
    Requested 2026-08-16:
    - menu.py: two new mode-list entries, "Power Off" and "Reboot".
    Neither executes on a single click -- selecting either drops into a
    Yes/No confirm stage defaulting to No, so a toddler wandering
    through the menu and clicking through it lands on "No" and cancels;
    a deliberate rotate-to-Yes-then-click is required to actually
    trigger it. 7 new pytest tests covering the confirm flow.
    - chromacade.py: wires the new ("system", "poweroff"|"reboot") menu
    result to an actual `shutdown -h now` / `reboot` call (no sudo
    needed, the service already runs as root).
    - Checked whether unit #1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
    [chromacade.py, menu.py, test_menu.py]
2026-08-16 Fix Power Off leaving "Shutting down..." frozen on screen forever
    Confirmed live 2026-08-16: the SSD1306 keeps driving whatever's in its
    own onboard display memory as long as it still has power, independent
    of whether the Pi's CPU is running -- shutdown -h now halts the OS but
    doesn't cut power to the board, so nothing ever told the display to
    change. Fix: show "Shutting down..." briefly, then update to "Powered
    off. / Safe to unplug." as the actual LAST write before triggering the
    halt, since whatever's on screen at that exact moment is what freezes.
    Reboot untouched -- confirmed working as-is, the OLED naturally
    refreshes once the service comes back up.
    [chromacade.py]
2026-08-16 Fix unreliable Tutor/Simon exit gesture: stop blocking note_on()
    Confirmed live 2026-08-16: hold-both-encoders + long-press C to exit
    an active Tutor/Simon session was unreliable. Root cause: C and B are
    real notes too, so pressing one to start the exit gesture also fires a
    normal note_on() -> miss_feedback() (or a round-complete/celebration)
    call -- these used to run inline and block for up to several seconds,
    long enough to disrupt gpiozero's own hold-timer for that same
    button's when_held callback, since both handlers are tied to the same
    Button object.
    Fix: everything note_on() can trigger during tutor_active/simon_active
    (miss feedback, round-complete sound + delay, the next round's de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
    [chromacade.py]
2026-08-17 Simplify menu gesture to hold-both-encoders, drop note-button long-press
    Requested live during hardware bring-up: holding both encoder
    push-buttons and then also having to long-press an edge note button
    (B to enter, C to exit) was an annoying extra step. Both encoder
    push-buttons held together is already a rare, inherently two-handed
    signal on its own (opposite ends of the shelf) -- the third
    simultaneous note-button press wasn't buying meaningfully more
    protection against toddler mashing.
    hardware_poller.py: replaced the C/B when_held-based gesture check
    with a threading.Timer armed the instant both encoder buttons are
    simultaneously down and cancelled the instant either releases, so a
    sin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
    [audio_engine.py, chromacade.py, hardware_poller.py, menu.py]
2026-08-17 Add Happy Birthday to Tutor mode, with octave/flat prompts
    Notes given phrase-by-phrase (verified, not a placeholder transcription
    like some of the other bundled songs): C4-C4-D4-C4-F4-E4 /
    C4-C4-D4-C4-G4-F4 / C4-C4-C5-A4-F4-E4-D4 / Bb4-Bb4-A4-F4-G4-F4. First
    song that crosses octaves (the C5 "dear" leap) or uses an accidental
    (Bb4 in the closing line), so it needed a new _phrase() helper
    alongside _score() -- _score() assumes one fixed octave and bare
    letters, which doesn't fit here. Rhythm is the standard well-known 3/4
    shape (eighth-eighth-quarter-quarter-quarter-half per line, one extra
    quarter on the "dear ___" line) -- not yet demo-verified by ear like
    the module docstring's other conf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
    [chromacade.py, tutor_songs.py]
2026-08-17 Transpose Happy Birthday to G major, dropping the flat entirely
    Replaces the C-major/Bb4 version from the previous commit. Transposed
    up a perfect fifth throughout, which turns the original's borrowed
    "flat-7 relative to tonic" note (Bb4, relative to C) into a plain
    natural (F, relative to the new G tonic) -- same relative scale
    degree, no accidental needed in this key. Verified by transposing
    every note and confirming the resulting letter set is all-natural.
    The "dear" leap now rides three notes up at G5 (G5-E5-C5, not just
    one high note) before landing back down at B4 -- a side effect of
    Bb4 sitting close to the octave-4/5 boundary in the original, so
    shifting it up a fifth pushes the who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
    [tutor_songs.py]
2026-08-17 Make Toy Piano the default font instead of Organ
    Organ was always an interim choice for bring-up testing (constant-
    volume sustain made it easier to evaluate every other control while
    they were still being built, per audio_engine.py's now-corrected
    module docstring). Now that the device is in actual use, Toy Piano
    fits the instrument's actual character better as the default voice.
    Reordered FONTS so Toy Piano is first (DEFAULT_PROGRAM = FONTS[0][0],
    same pattern the code already used for Organ) rather than special-
    casing the default separately -- font_index/TUTOR_FONT_INDEX both
    already resolve by name/program lookup, not a hardcoded index, so
    reordering the list doesn't break anything els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
    [audio_engine.py, chromacade.py]
2026-08-17 Update parent page: simplified menu gesture, new support email
    Gesture instructions still described the old hold-both-encoders +
    long-press B/C combo, stale since the menu-toggle simplification
    earlier this branch. Also switching the support contact from
    banjopuppet@gmail.com to shane@fluxconstant.com.
2026-08-17 Document unit #1 shipping without the back-panel cooling fan
    chromacade-back-panel.scad's fan vent cutout (print-validated
    2026-08-15) isn't being populated on unit #1 -- no room for a fan
    given how crowded the interior already is, and the heat sink in use
    is large enough that active cooling isn't needed. Left the CAD
    geometry itself untouched (a full enclosure redesign is planned next,
    so patching this file now would likely just be thrown away). Recorded
    in decision-log.md (Case geometry) and flagged in open-questions.md's
    Future/stretch section to revisit fan cooling on the next build.
2026-08-17 Tutor mode keeps whichever font was already selected
    Previously start_tutor() force-switched to Toy Piano (TUTOR_FONT_INDEX)
    and restored the prior font on exit/completion, same as Simon mode
    still does -- originally for repeated-note clarity (a font with a
    long/blended attack can make back-to-back identical notes sound like
    one held tone rather than two presses). Requested change: Tutor should
    just play in whatever font is currently selected, accepting that
    tradeoff in exchange for letting the chosen instrument carry through
    into Tutor sessions. Simon mode's forced-Toy-Piano behavior is
    untouched -- not asked for, and Simon's number/random sources are more
    prone to back-to-back identical le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
2026-08-17 Add user-songs/ for personal, unpublished Tutor songs
    Requested to replace the git-stash workflow used so far for personal
    songs (e.g. copyrighted material fine to play on your own instrument
    but not to publish in this public repo) -- stashing/unstashing
    tutor_songs.py across every branch switch and pull was getting
    tedious and error-prone.
    tutor_songs.py's new load_user_songs() loads every .py file in
    user-songs/ at import time (each defining module-level NAME, SCORE,
    and optionally PROMPTS -- same format as this file's own SCORES/
    PROMPTS) and merges them in before SONGS is derived, so a personal
    song shows up in the Tutor menu and as a Simon sequence source
    exactly like a bundled one. Th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
    [test_tutor_songs.py, tutor_songs.py]
2026-08-17 Note the record-mode oopsie/undo-last-note requirement
    Requested addition to the record-your-own-song idea: needs a way to
    delete the last-recorded note mid-take rather than forcing a full
    restart on a mis-press. No control chosen yet -- flagged the octave/
    font encoder push-buttons as candidates since both already change
    meaning by app state elsewhere.
2026-08-18 Document unit #2: Raspberry Pi 4B (1GB), hostname plinkplonk
    Unit #1 (chromacade, Pi Zero 2W) is no longer available -- this is a
    fresh build, not a repair, and resolves the "Zero 2W vs spare 3B vs
    maybe 4B" next-build musing from the fan-removal conversation: 4B
    specifically, not 3B. Recorded the board choice and reasoning in
    decision-log.md's Platform/compute section, and added an anchor entry
    at the top of open-questions.md's Future/stretch section so the
    existing "for the next build"/"unit #2" items (fan reintroduction,
    overlay-fs, dedicated service user) all point at a concrete unit
    instead of a vague future one. Enclosure redesign for better fit and
    interior accessibility is part of th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
2026-08-18 Document the temporary plinkplonk branching exception in CLAUDE.md
    Main's hard "branch off main, PR into main" rule doesn't fit unit #2
    development well -- exploratory enclosure/hardware-fit churn
    shouldn't land on main piece by piece. Documents the agreed exception:
    branch off plinkplonk (unprotected, unlike main) instead, PR into it
    as the base, user still does all final merges by hand either way.
    Also updated the stale "Syncing the physical board" section, which
    still described chromacade (unit #1, no longer available) as the
    current device.
2026-08-18 Scale enclosure +10%/+25%, split bottom+back into removable L-bracket
    Overall case +10% (case_w, case_d, front_h, panel_l) for more interior
    room; controller shelf +25% (shelf_d) for extra clearance around the
    4-control cluster. Hardware cutout sizes/positions are unscaled - those
    match real component footprints, not case size.
    Retires chromacade-back-panel.scad (back-only removable cover) in favor
    of chromacade-bottom-back.scad: the base and back wall combine into one
    removable L-bracket (90 deg corner, small fillet) that screws off the
    shell, giving full interior access for wiring/assembly rather than just
    battery/SD swaps - addresses the cramped-assembly problem noted during
    unit #1's wi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
    [chromacade-back-panel.scad, chromacade-bottom-back.scad, chromacade-housing-embossed.scad, chromacade-housing.scad, chromacade-housing.stl]
2026-08-18 Redesign enclosure split: pot-side / blank-side by print orientation
    Replaces the shell+bottom-back-bracket split from earlier today with a
    split by which side wall each piece owns: pot-side (volume-pot side wall
    + back + bottom) and blank-side (other side wall + front + shelf + panel
    + top). Each piece prints with its own side wall face-down on the bed,
    so the main structure is a straight extrusion along the print's vertical
    axis with zero overhang anywhere - eliminating the support material the
    45-degree panel would otherwise need.
    Built by partitioning one shared shell solid via intersection() with a
    half-plane mask (split along the diagonal p1-p5 line) rather than
    independently-inset op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
    [chromacade-blank-side-embossed.scad, chromacade-blank-side-embossed.stl, chromacade-blank-side.scad, chromacade-bottom-back.scad, chromacade-housing.stl, chromacade-pot-side.scad, chromacade-pot-side.stl]
2026-08-18 Fasten pot-side/blank-side along X instead of the diagonal p1/p5 seam
    The seam-boss design put mounting bosses on the diagonal p1/p5 line,
    anchored well back from it to clear both the seam's own diagonal
    cutback and the other piece's wall thickness - which put the screw
    entry point up to 6" from the boss. Not a workable fastening scheme.
    Replaced with 9 mounts screwing along X (the case's width axis), each
    right at the owning piece's own edge:
    - pot-side owns 4 (2 into the bottom strip, 2 into the back strip)
    - blank-side owns 5 (front wall bottom/top, shelf/panel joint,
    panel/top joint, top/back joint)
    Whichever piece owns a mount gets a 3mm pilot bore straight into its
    existing strip/e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
    [chromacade-blank-side-embossed.scad, chromacade-blank-side-embossed.stl, chromacade-blank-side.scad, chromacade-pot-side.scad, chromacade-pot-side.stl]
2026-08-18 Fix undefined-variable bug that silently dropped every owned mount hole
    edge_x referenced edge_clearance before it was defined later in the
    file (near strips()). OpenSCAD doesn't error on a forward reference to
    a top-level variable - it warns "Ignoring unknown variable" and
    evaluates the expression as undef, which silently drops every
    translate() built from it. In practice this meant every "owned" mount
    pilot bore (pot_side_mounts(), blank_side_mounts()) never actually cut
    where intended - only the clearance holes (which don't depend on
    edge_x) were real. Compiling either file showed the warnings; visually
    the holes were missing or clustered at the origin instead of at each
    piece's edge.
    Fi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
    [chromacade-blank-side-embossed.scad, chromacade-blank-side-embossed.stl, chromacade-blank-side.scad, chromacade-pot-side.scad, chromacade-pot-side.stl]
2026-08-18 Update unit #2 hostname/path references now that plinkplonk is online
    Surveyed all 201 case-insensitive "chromacade" occurrences across the
    repo (47 files) before touching anything -- almost all are the
    product name (ChromaCadeAudio class, chromacade.py/chromacade.service,
    enclosure .scad filenames, README/CONTRIBUTING.md, etc.) or correct
    historical references to unit #1 specifically, neither of which should
    change. Only two were genuinely stale device-identity placeholders:
    - CLAUDE.md's "Syncing the physical board" section had a "path TBD"
    placeholder from before plinkplonk was online -- filled in with the
    confirmed actual path (/home/plink/ChromaCade/, user plink not
    shane) and SS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
2026-08-18 Switch plinkplonk sub-branch naming to plonk/task-name
    Requested: per-contributor prefix (yourname/task) doesn't reflect
    reality with effectively one active contributor, so use a scope-based
    prefix instead for branches under the plinkplonk integration effort.
    First attempt was plinkplonk/task-name, which git rejects outright
    while the bare plinkplonk branch exists -- a ref can't be both a leaf
    and a directory in git's internal ref tree (confirmed live:
    `fatal: cannot lock ref ... 'refs/heads/plinkplonk' exists`). plonk/
    (short for plinkplonk) sidesteps the collision since it's a distinct
    name with no bare branch of its own.
    Scoped to the plinkplonk exception only -- main's yourname/task-
    d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
2026-08-18 Add square reinforcing bosses around each mount, size for M3 screws
    Bare pilot bores in the strip's own wall material (5mm) only left
    ~1mm of radial wall on each side of a centered bore - thin enough to
    risk cracking under screw torque or an edge-on drop impact, a real
    scenario here (needs to survive a toddler pushing the case off a
    table onto a hard floor, landing on an edge).
    Each owned mount now gets a square reinforcing boss (not round - full
    flush-face contact against the surrounding wall, same rationale as
    the original pre-split mounting_boss() module) around its pilot bore,
    45-degree-ramped toward its own piece's bed side. Also switched pilot/
    clearance sizing to match M3 screws: 2.5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
    [chromacade-blank-side.scad, chromacade-pot-side.scad, chromacade-pot-side.stl]
2026-08-18 Log cooling fan spec for unit #2 (side fans, not active cooler)
    8-pack brushless Pi cooling fans: 7mm thick, 2-wire DC (3.3V/5V, no
    PWM/tach), M2.5x15mm mounting screws included, one-to-two splitter
    included. Side-panel case fans + heatsinks for this unit specifically
    -- intermittent ~1hr/day play use doesn't justify active SoC cooling,
    unlike the separate dev-unit plan (runs constantly during iteration).
    Flagged two things for whoever does the CAD work: screw length is
    untested against the actual enclosure wall thickness (not finalized
    yet, may need longer screws once known), and brushless DC fans can't
    have their direction reversed by swapping polarity -- that just stops
    them spinning rat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
2026-08-18 Lower pot-side's two bottom-strip mounting bosses to the rim height
    Rendered pot-side.scad in isolation and confirmed visually: the two
    bottom-strip mounts' full boss_w(12) height stuck up well above the
    bottom strip's own perimeter rim, which is only wall(5) tall there --
    visible as a protruding block rather than sitting flush. The two
    back-strip mounts don't have this problem (they extend into open
    interior depth, not up past a short rim), so they're untouched.
    square_boss() gains an optional height param (defaults to boss_w, so
    the back-strip calls are unaffected) used only for thick_axis="z".
    The two bottom-strip calls now pass height=wall, capping them at the
    rim height instead of the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
    [chromacade-blank-side-embossed.scad, chromacade-blank-side.scad, chromacade-pot-side.scad]
2026-08-18 Move volume pot hole from case_d/3 to case_d/4 -- too close to OLED
    [chromacade-pot-side.scad]
2026-08-18 Revert comment touch on the embossed variant -- pausing on it
    Per instruction: hold off developing chromacade-blank-side-embossed.scad
    until the wordmark is redesigned for PlinkPlonk. CLAUDE.md (this branch)
    already flags this file as deliberately left on the older mount system
    (pilot_d=3/clear_d=3.5, not blank-side.scad's 2.5/3.4) pending the
    rename -- my earlier comment-only edit to it (in the mounting-boss fix
    commit) shouldn't have touched it at all, even non-functionally.
    Reverted back to its original comment, no functional change either
    commit.
    [chromacade-blank-side-embossed.scad]
2026-08-18 Fix mounting bosses poking through exterior surfaces on both pieces
    Live visual check (both pieces rendered and inspected) found two
    distinct problems with how the reinforcing bosses around each mount's
    pilot bore were placed, on top of the bottom-strip height issue fixed
    earlier this session:
    pot-side.scad: the bottom-strip bosses' first-pass fix (height=wall,
    this branch's earlier commit) capped them at the bare wall thickness,
    which just made them coincide with material that's already there --
    no actual reinforcement, and visibly "embedded in"/centered within the
    panel rather than a distinct standing feature. Corrected: boss's
    bottom face now flush with the bottom strip's own INTERIOR su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
    [chromacade-blank-side.scad, chromacade-pot-side.scad]
2026-08-18 Sync blank-side's clearance holes to pot-side's corrected bore position
    Follow-up to c6d87a5 -- pot-side's bottom-strip bores moved to
    wall + boss_w/2 (flush with the interior surface, standing into the
    enclosure), so blank-side's matching clearance holes need the same Z
    value or the two pieces' screws won't line up.
    165 tests pass.
    [chromacade-blank-side.scad]
2026-08-18 Fix boss tapers: wedges, not pyramids; fix blank-side margin bug
    Two more real problems found on live inspection:
    blank-side.scad was "completely broken" -- margin=15 (an 80mm-square
    oversized block) was way bigger than this case's ~126x105mm interior,
    so intersecting it with interior_void() wasn't landing a small boss
    near each mount point at all -- it was capturing a huge chunk of the
    actual profile boundary nearby, producing the profile's own multi-
    segment steps instead of a boss. Reduced to margin=15 (30mm), still
    comfortably more than any local wall thickness/tilt needs (wall=5,
    worst case ~7mm crossing a 45° segment) while actually staying local.
    Both files' boss tapers were pyrami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
    [chromacade-blank-side.scad, chromacade-pot-side.scad]
2026-08-19 adjusted mounting bosses and holes placements and volume hole
    [chromacade-pot-side.scad]
2026-08-19 Add combined fit-check mockup, grokwell-PiLC PART-selector methodology
    One file with a PART selector (ASSEMBLY / BLANK_SIDE / POT_SIDE / one
    per component) so the two real case pieces and every non-printed
    hardware mockup -- pot, OLED, LED ring, LED strip, Pi4+HAT stack,
    rocker switch, both EC11 encoders, joystick -- can be previewed
    together for clearance before anything is finalized. Mockups are
    placed at their actual cutout coordinates and dimensioned off the best
    available spec, flagged MEASURED or ESTIMATE per constant so real
    caliper readings can replace the estimates as parts get measured.
    Also brings CLAUDE.md's file list up to date with this new file.
    [chromacade-fit-check.scad]
2026-08-19 Add joystick mounting bosses, update mockup dims from real measurements
    Real caliper numbers from the physical parts (2026-08-18): EC11 encoder
    body 15x12x10mm, rocker switch body a 20mm x 40mm-deep cylinder
    (factory leads included), 7 MX note-key switches reach 8mm into the
    interior, joystick board is 26x33mm with corner holes at 14mm/12.5mm
    off-center (+/-9mm each). Rocker/encoder hole sizes already cut are
    confirmed correct.
    Joystick gets a real redesign: 4 standoff bosses (12mm deep) on the
    shelf interior, positioned at the board's actual corner holes, added
    to chromacade-blank-side.scad and mirrored in chromacade-fit-check.scad.
    Stick hole is under active test at 26.5mm (was 20.5, unva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
    [chromacade-blank-side.scad, chromacade-fit-check.scad, test-mk2.scad]
2026-08-19 Fix rocker/joystick swap on the shelf (was mirrored left-right)
    Confirmed in play position (facing the front of the case from
    outside), RIGHT is the -X direction here -- the joystick belongs at
    x=-65 (far right, paired with the font encoder at x=-35) and the
    rocker at x=70 (far left, paired with the octave encoder at x=45).
    Both files had these swapped: the joystick's 26.5mm-under-test hole
    and new mounting bosses were on the rocker's x=70 hole, and the
    rocker's already-correct 20.5mm hole was about to get bosses it
    doesn't need. Swapped the two holes/diameters back, moved joy_x to
    -65, and fixed which encoder is "octave" vs "font" in
    chromacade-fit-check.scad's mockups to match. Verified wi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
    [chromacade-blank-side.scad, chromacade-fit-check.scad]
2026-08-19 Rocker hole to 20mm exact; mock up new dual-cone speaker housings
    Rocker hole was 20.5mm (the closest earlier measurement got); user
    confirmed it should be exactly 20mm -- fixed in both
    chromacade-blank-side.scad and chromacade-fit-check.scad, plus the
    stale ROCKER_HOLE_D=28 documentation constant left over from the
    rocker/joystick mixup (never actually wired to geometry, but wrong and
    misleading).
    Added a mockup for the new dual-cone speaker housings (98x43x20mm,
    two 35mm cones each 22.5mm off-center) at chromacade-fit-check.scad's
    existing spk_cx=+/-45 grille positions, to check fit against the
    current grille layout. It doesn't fit: at 98mm wide and only 90mm
    apart, the two housings overl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
    [chromacade-blank-side.scad, chromacade-fit-check.scad, test-mk2.scad]
2026-08-19 Fold in local edits to test-mk2.scad plates A/B/D
    Drop the "ENC"/"JOY" raised labels (empty top_label() calls), move the
    encoder and OLED back countersinks to be centered on the back face
    with a taller cut (13x13x3 and 30x30x3, ~1.5mm effective depth each,
    was 14.3x14.3x1 and 30x30x2) for a more robust boolean subtraction
    across the surface plane, and offset the OLED front window 2mm
    off-center. Header table updated to match. Kept the PART selector and
    plates C/E as-is -- not present in the pasted diff, presumably
    unchanged locally.
    [test-mk2.scad]
2026-08-19 Drop labels from remaining test-mk2 plates, remove label helper
    Per feedback: labels on throwaway fit-test plates waste PLA and print
    time. Plates A and B already had empty label calls from a prior edit;
    removed those calls entirely (not just emptied) plus plate E's "SPK"
    label, and deleted the now-unused top_label() module and lbl_h
    constant. Plate E's plate height keeps its existing margin (comment
    updated, not resized, to avoid touching the layout math in row1_y).
    [test-mk2.scad]
2026-08-19 Correct WM8960 driver setup notes, document plinkplonk fix
    open-questions.md's WM8960 entry was stale -- written 2026-07-26
    before the HAT was actually adopted, and assumed the driver would
    need a vendor DKMS install script like the older seeed-voicecard
    driver. Diagnosed and fixed plinkplonk's aplay -l not showing the
    card: I2C/I2S were disabled and no overlay was loaded. Turns out
    current Raspberry Pi OS (kernel 6.18.x) ships wm8960-soundcard.dtbo
    as a stock overlay -- just needed dtparam=i2c_arm=on, dtparam=i2s=on,
    and dtoverlay=wm8960-soundcard in config.txt, then a reboot. Verified
    via aplay -l (card shows up), i2cdetect (codec responds at 0x1a), and
    a speaker-test run (no ALSA errors).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
2026-08-19 Deepen OLED/encoder countersinks to ~3mm; joystick hole to 27mm
    Print test results 2026-08-19: 13x13mm encoder lateral size and
    30x30mm OLED lateral size + 2mm window offset were both already
    correct, but both countersinks needed to sink in further -- doubled
    effective depth from ~1.5mm to ~3mm (cube height 3->6, still centered
    on the back face for the same reliable-opening margin). Joystick's
    26.5mm test hole was a tiny bit too small; bumped to 27mm in
    test-mk2.scad plate B and mirrored into chromacade-blank-side.scad's
    real cutout and chromacade-fit-check.scad's JOY_STICK_D, same pattern
    as the earlier 28->26.5 change.
    [chromacade-blank-side.scad, chromacade-fit-check.scad, test-mk2.scad]
2026-08-19 Redesign joystick mounting bosses as wedges curving around the hole
    Straight cylindrical bosses were close enough to the stick hole to
    collide with the joystick's own range of motion, and got an
    accidentally-thin crescent of material wherever the hole clipped
    through them. Replaced with ring-segment wedges (joy_boss_wedge_2d())
    that only ever have material outside the hole's edge (plus a small
    clearance gap) -- never intruding into the hole -- reaching out to a
    fixed radius for a deliberate, generous wall around each pilot bore
    instead of whatever the hole cut happened to leave behind.
    Found and fixed a CGAL rendering bug along the way: an outer radius
    of 21mm rendered chromacade-blank-side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
    [chromacade-blank-side.scad, chromacade-fit-check.scad, test-mk2.scad]
2026-08-19 Fold in LED ring back-recess depth fix (plate C)
    Same fix pattern as plates A/D: center the back recess on the back
    face with a taller cut (d=28, h=6, centered at wall) instead of
    ending exactly at the surface, for the same reliable-opening margin
    and deeper (~3mm vs ~1mm) effective cut. Header table updated to
    match.
    [test-mk2.scad]
2026-08-19 Redesign speaker grilles for the new dual-cone housing (one housing)
    Replaced the two old single-cone stadium grilles (spk_grille_w/h,
    spk_cx = +/-45) with two round hex grilles (spk_cone_d=35,
    spk_cone_offset=22.5) on a single centered dual-cone housing.
    Two separate housings (4 total cones) don't fit on this front wall:
    even edge-to-edge with zero margin they'd need case_w >= 206mm,
    over the 203.2mm (8in) print bed limit -- confirmed by computing the
    minimum before touching any geometry. One housing (98x43x20mm, 2
    cones) fits comfortably: 44mm margin to each endcap horizontally,
    ~3mm margin top/bottom vertically. Applied to both
    chromacade-blank-side.scad's real cutout and
    chromacade-fit-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
    [chromacade-blank-side.scad, chromacade-fit-check.scad]
2026-08-19 Document the speaker housing count/print-bed decision in decision-log.md
2026-08-19 Remove plate E (old stadium speaker grille) from test-mk2.scad
    The speaker design changed to a dual-cone housing with round grilles
    (chromacade-blank-side.scad's spk_cone_d/spk_cone_offset) -- the old
    1"x1.5" portrait stadium shape doesn't match anything real anymore.
    Removed test_speaker_mk2() and its now-unused stadium_hex_grill_cut()
    helper and in2mm constant, updated the header table/PART selector/
    layout math for the remaining 4 plates, and noted there's no
    replacement speaker test plate yet.
    [test-mk2.scad]
2026-08-19 Add Raspberry Pi 4B mounting bosses to pot-side's bottom floor
    4 standoffs at the official Pi4B hole spacing (58x49mm), 5mm tall,
    ramping 45 degrees toward -X (this piece's own bed/endcap side) same
    as the existing case-joining bosses on this floor -- new pi_mount_boss()
    centers the boss on the true hole position (unlike square_boss(),
    which anchors its far edge at a piece's own X boundary for the
    case-joining screws) since the Pi board's holes are a fixed spec, not
    something to offset around. Pilot holes drilled straight down (Z),
    not sideways like the case-joining bores, since the board sits on top
    of these and screws drive down through it.
    Positioned near the back wall, 10mm minimum clea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
    [chromacade-fit-check.scad, chromacade-pot-side.scad]
2026-08-20 Apply confirmed encoder/OLED/LED-ring depths to production cutouts
    Print-tested and confirmed correct 2026-08-19 (test-mk2.scad plates
    A/C/D): encoder countersink 13x13mm (~3mm effective depth, was
    14.3x14.3x1mm), OLED window 2mm off-center + 30x30mm countersink
    (~3mm effective depth, was 2mm), LED ring back recess (~3mm effective
    depth, was 1mm) -- all using the same "centered on the interior face,
    taller cut" pattern already validated on the test plates. Applied to
    chromacade-blank-side.scad's real cutouts and mirrored into
    chromacade-fit-check.scad, including repositioning the OLED/LED ring
    mockup components to rest on the new pocket floor depth.
    [chromacade-blank-side.scad, chromacade-fit-check.scad]
2026-08-20 Fix rocker hole (revert to 20.5mm) and encoder/speaker collision
    Rocker hole: reverted 20mm back to 20.5mm exact per re-review -- the
    20mm-exact change from earlier today was wrong.
    Encoder/speaker collision: chromacade-fit-check.scad's ASSEMBLY view
    showed the two shelf encoders' bodies (15x12x10mm, reaching 10mm
    behind the panel) colliding with the new single speaker housing.
    Computed the actual 3D bounding boxes to confirm and quantify: real
    overlap of ~1.7mm at the encoders' original shelf position. Shifted
    both encoders -7mm along the shelf (toward the back, away from the
    front wall) via a new enc_pos_y constant -- gives 5.27mm clearance,
    just over the 5mm minimum specified. Applied to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
    [chromacade-blank-side.scad, chromacade-fit-check.scad]
2026-08-20 Pull joystick mounting bosses into isolated dev file for redesign
    Direct feedback on the printed test: straight-up-and-down bosses got
    in the way of the joystick's own range of motion, two of the four
    didn't have enough material to fully encase their screws, and --
    found while redesigning -- weren't actually support-free to print
    either. Root cause: their taper was along the shelf's own local Z
    axis, not blank-side's real print-vertical axis (global X, since
    blank-side prints with its own endcap face-down and builds toward -X)
    -- a hull()-based taper along the wrong axis doesn't help printability
    at all.
    New design in enclosure/joystick-mount-dev.scad, built and verified in
    isolation: each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
    [chromacade-blank-side.scad, chromacade-fit-check.scad, joystick-mount-dev.scad, test-mk2.scad]
2026-08-20 Redesign joystick bosses around a gimbal-clearance sphere
    Per feedback: the first ramped redesign (a hole-clipped wedge) fixed
    print support but still didn't clear the joystick's actual moving
    space -- clipping against the flat 27mm stick-hole radius only
    protects the visible opening, not the gimbal mechanism's real swept
    volume underneath the board.
    New approach, much simpler: each boss is now a plain constant-width
    post (no wedge/angular-clipping math at all), built with the same
    thin-slice hull() ramp for print support, and a single 26mm sphere
    centered on the stick hole (at the shelf surface) is subtracted from
    the whole assembly. The sphere is deliberately smaller than the
    27mm stick h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
    [joystick-mount-dev.scad]
2026-08-20 Fix impractical print proportions, add unrotated plate preview
    Found while answering "where's the shelf plate": printable_dev()'s
    70x60mm plate became a 70mm-TALL, only 4x60mm-footprint print after
    the auto-rotation -- local +X (the ramp axis) has to map to vertical
    for the posts to print without support, and that axis was the plate's
    full 70mm width, not its 4mm thickness. Shrunk plate_w to 44mm (sized
    to the posts' actual X-spread, -13 to 21, not an arbitrary round
    number) and re-centered it (plate_cx=4, the spread isn't symmetric) --
    still tall and narrow-footprint by geometric necessity, but far more
    reasonable, and documented why in printable_dev()'s own comment
    (suggest a slicer brim,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
    [joystick-mount-dev.scad]
2026-08-20 I removed a sphere from the joystick mount to allow the joystick shroud to move
    [sphere-removed.stl]
2026-08-20 Revert joystick bosses to the printed straight-post design, sphere r=13.5
    Per direct feedback that sphere-removed.stl was an imprecise conceptual
    sketch, not a reference to reverse-engineer: drop the wedge/ramp
    redesigns entirely and go back to exactly what got physically printed
    (a4f6a10's plain d=6mm, h=12mm vertical cylinders, no taper), then
    subtract a single sphere (r=13.5mm, matching the stick hole's own
    27mm diameter) centered precisely on the stick hole's true center
    (shelf mid-thickness, not the interior face).
    PRINTABLE mode simplified to match -- straight posts need no
    print-support rotation, so it now renders the plate right-side-up.
    Note for follow-up: at this exact radius/pos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
    [joystick-mount-dev.scad]
2026-08-20 Fix dev-file test plate thickness; mark joystick stick hole confirmed
    joystick-mount-dev.scad: the printable coupon's test plate was 4mm thick
    and positioned one full plate-thickness further into the interior than
    the boss's own reference point, instead of the real shelf's actual 5mm
    wall spanning the exterior face (z=0) down to the interior face
    (z=-wall). That mismatch let each boss's small 0.5mm CSG-safety overlap
    (joy_boss_dev(), there to fuse cleanly into surrounding material) poke
    visibly above the plate's own top surface. Fixed the plate to the real
    wall thickness/position -- verified via STL vertex extraction that
    nothing now exceeds z=0, and the boss/plate union is flush at z=-wall.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
    [chromacade-blank-side.scad, chromacade-fit-check.scad, joystick-mount-dev.scad]
2026-08-20 moved some mounts to adjust for new speakers
    [chromacade-pot-side.scad]
2026-08-20 Fix back-strip mount bosses: flush with interior face, not exterior
    square_boss()'s "y" (back-strip) branch never got the interior-flush fix
    the "z" (bottom-strip) branch already had: it started at the back wall's
    EXTERIOR surface (y=0) and only reached 12mm deep, instead of starting at
    the INTERIOR surface (y=wall) and reaching boss_w past that. Found by
    direct inspection: the pilot bore ended up centered only 6mm from the
    exterior back surface (vs 11mm for the bottom-strip bores), not enough
    material behind the screw to survive an edge-on drop -- exactly the
    "broken mount waiting to happen" this project's boss reinforcement
    exists to prevent.
    Added a y_start parameter to square_boss() (mi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
    [chromacade-blank-side.scad, chromacade-fit-check.scad, chromacade-pot-side.scad]
2026-08-20 Rebuild blank-side's mount bosses on the correct positions/standard
    Investigating "create mount bosses on the blank-side.scad that meet
    those holes" turned up a real, longstanding bug: own_mount_boss_centers
    had drifted from pot-side.scad's blank_side_mount_yz (the two arrays
    both claim, in their own comments, that they "must stay identical") by
    up to 22.74mm on one mount and was off on all 5 -- meaning blank-side's
    pilot bores never actually lined up with pot-side's clearance holes,
    undetected because nothing checks the two arrays against each other.
    Also found the same class of bug on pot_side_mount_yz's first entry
    (100, stale against pot-side's own 110 after "moved some mounts to
    adjust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
    [chromacade-blank-side.scad, chromacade-fit-check.scad]
2026-08-20 Build and verify /etc/asound.conf on plinkplonk
    Standard hw -> dmix -> softvol -> plug/default chain, named by card
    name (wm8960soundcard) per this project's established convention
    (decision-log.md). Closes the gap flagged in the previous commit on
    this branch (0ed7d1b) -- the driver overlay fix got the card showing
    up in aplay -l, but no default ALSA routing existed yet.
    Verified live on the device, not just written: speaker-test -D default
    plays cleanly, amixer sget PCM shows the new softvol control at
    100%/0.00dB, and two concurrent speaker-test processes both play
    without error (confirms dmix sharing actually works).
2026-08-20 Fix silent speaker output: WM8960 output mixer routing was off
    speaker-test/aplay completing with zero ALSA errors -- through
    asound.conf's default device AND straight to the raw hw:wm8960soundcard
    device, bypassing asound.conf entirely -- turned out not to mean audible
    sound. Root cause was two levels below ALSA: the WM8960 codec's own
    Left/Right Output Mixer PCM switches (which route the DAC signal into
    the speaker output stage) default to off, independent of the Speaker/
    Playback volume controls, which were already fine.
    Fixed with amixer sset 'Left/Right Output Mixer PCM' on, then
    alsactl store to persist (alsa-restore.service was already active and
    picks this up at boot -- confirmed in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
2026-08-20 Fix blank-side mount bosses: wrong taper direction, wrong shape
    Two real bugs found by direct inspection of the previous commit's
    render, per direct feedback:
    1. flat_mount_boss()'s taper had the thin end anchored at the FREE
    (interior-facing) side instead of the WALL side -- exactly backwards
    from pot-side's square_boss(), which keeps the wall-touching face
    fixed across the whole taper. The wall is solid at every X-slice
    (part of the uniform extrusion), so pot-side's version always has
    something to grow out of; this version's thinnest point floated in
    open interior air, touching nothing. Since this piece prints with
    its endcap face-down and the mount region sits far fr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
    [chromacade-blank-side.scad, chromacade-fit-check.scad]
2026-08-20 Reposition blank-side mounts: remove one, fix two, center two
    Per direct feedback on the corrected-shape render:
    - shelf_panel mount (Y=74,Z=48) REMOVED entirely -- "hanging off in
    space," not landing on solid material worth reinforcing. Now 4 mounts
    total, not 5.
    - panel_top mount moved from [45,73] to [56.701,61.834] (local (y=15,
    z=-11) in the panel's own rotated frame) -- the old position collided
    with the OLED cutout (confirmed: OLED's local y-span [-20.5,-5.5]
    overlapped the boss's old y=-1.170+/-6). y=15 matches the MX note-key
    row's own local y ("in line with the note keys"); verified no overlap
    with the actual key cutouts either (nearest key clears the boss's X
    rea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
    [chromacade-blank-side.scad, chromacade-fit-check.scad, chromacade-pot-side.scad]
2026-08-20 Port joystick mounting harness back into chromacade-blank-side.scad
    The design in joystick-mount-dev.scad has been stable since reverting to
    the physically-printed straight-post shape (a4f6a10: plain d=6mm/h=12mm
    vertical cylinders, no taper) plus one addition, a gimbal-clearance
    sphere (r=13.5mm, centered precisely on the stick hole's true center) --
    ported back per direct request.
    Added joystick_mount_bosses()/joystick_mount_pilot_holes()/
    joystick_gimbal_clearance(), built in the shelf's own local frame (same
    translate/rotate hardware_cutouts() already uses for the stick hole and
    encoders) shifted to joy_x, wired into the main assembly. Constants
    (joy_hole_dx, joy_hole_front_dy/back_dy,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
    [chromacade-blank-side.scad, chromacade-fit-check.scad]
2026-08-20 Note front_top/joystick boss overlap is a confirmed non-problem
    Flagged 2026-08-19 as a possible blocker needing a design decision;
    user checked the actual model and confirmed it's fine -- two solid,
    static boss/post regions overlapping just means more merged plastic,
    not a functional defect the way overlap with something that actually
    needs clearance (a moving part, a screw's access path) would be.
2026-08-20 add fan dimension diagram
2026-08-20 Add side-panel cooling fan cutouts, relocate volume-pot hole
    Real fan hardware finally speced (hardware-bom.md commit 08a6143,
    dimensioned in enclosure/fan-dimensions.jpg, both already on origin):
    30x30x7mm brushless side-panel fan, M2.5 hardware, 24mm hole spacing.
    Replaces the old unpopulated 39mm/32mm-spacing back-wall vent entirely
    -- that was sized for a fan that was never actually sourced; not a
    resize, a completely different part/location. One fan per endcap
    (fan_cutout() in both chromacade-pot-side.scad and
    chromacade-blank-side.scad) for a straight cross-case draft over the
    Pi/HAT stack, not two fans recirculating on one wall.
    Position iterated twice, both times per direct instruct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
    [chromacade-blank-side.scad, chromacade-fit-check.scad, chromacade-pot-side.scad]
2026-08-20 Add device rebuild guide, verified live against plinkplonk
    Direct response to unit #1 being lost with no equivalent record --
    "keep track of everything needed to rebuild this system on a new
    device." Every command in the new doc was actually run against
    plinkplonk during this session, not guessed:
    - Boot config: the 3 config.txt lines WM8960 needs (confirmed the rest
    of that file is stock Raspberry Pi OS defaults, not project-specific).
    - System packages: the full apt list, all Debian-packaged, no PEP 668
    friction.
    - Python packages: the Adafruit CircuitPython stack (board/busio/
    neopixel/adafruit_ads1x15/adafruit_ssd1306) was NOT installed on
    plinkplonk at all until this session --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
2026-08-20 Track asound.conf and fix chromacade.service's stale unit #1 paths
    Per direct instruction: git-add the audio config and service file
    instead of leaving them as device-only/stale, and document how to
    adapt them for different hardware.
    audio/asound.conf: the live, verified ALSA config from plinkplonk,
    previously only living at /etc/asound.conf on the device itself, not
    tracked anywhere. Added a real "adapting this for a different DAC"
    section (card name via aplay -l, sample rate, period size, and a note
    that the WM8960 mixer-routing fix is codec-specific and a different
    DAC may need a different equivalent), not just a WM8960-only file.
    chromacade.service: found ExecStart/WorkingDirectory sti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
2026-08-20 Track asound.conf and fix chromacade.service's stale unit #1 paths
    Same fix as plonk/device-rebuild-guide, mirrored here since this is the
    branch plinkplonk (the device) actually has checked out right now.
    See that branch's commit for the full reasoning.
2026-08-20 Nudge volume-pot hole for real clearance against its actual can size
    The fan-driven pot relocation earlier only checked clearance against
    the 9.525mm bushing hole, not the pot's actual can body behind the
    panel. User measured it at 24mm (well past the 16mm this project had
    been assuming, see chromacade-fit-check.scad's POT_CAN_D, now corrected
    from ESTIMATE to MEASURED) -- with the real size, the current (15,48)
    position left only 3.00mm to the case profile edge. Positive clearance,
    not an overlap, so the print already underway on it was left to finish
    rather than stopped; this fix is for the next run.
    Nudged to (18,45) -- 4.24mm move, doubles the edge clearance to 6.00mm
    while keeping 8.00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
    [chromacade-fit-check.scad, chromacade-pot-side.scad]
2026-08-20 moved pot hole
    [chromacade-blank-side.stl, chromacade-pot-side.stl, test-mk2.stl]
2026-08-20 moved pot hole, removed old images
2026-08-20 adding updated scad
    [chromacade-pot-side.scad]
2026-08-20 Verify new pot position (22,65) and mirror into fit-check.scad
    The (22,65) move landed on origin as a bare STL re-export with no .scad
    change alongside it -- source and checked-in geometry disagreed on the
    real pot position for two commits until "adding updated scad" caught
    the .scad up. Confirmed via probing the checked-in STL directly (solid
    material at the old (18,45) position, proving it had moved) before the
    source update arrived.
    Verified the new position properly once the source matched: clean
    2-volume manifold renders on both real pieces, pot-side/blank-side
    interference check is empty (no collision), and computed clearances
    are the best of the three positions tried -- 10.00mm to th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
    [chromacade-fit-check.scad, chromacade-pot-side.scad]
2026-08-20 Add bench test for candidate NeoPixel Ring 16
    Not the project's decided ring/strip -- a bench evaluation of a
    different, not-yet-committed 16-LED ring being tried as a possible
    swap-in, wired to GPIO12 (physical pin 32, matching the real ring's
    proven pin, not physical pin 12/GPIO18 which this build's I2S audio
    already claims for BCLK -- confirmed live via pinctrl on plinkplonk).
    Cycles the 7 hex values docs/color-palette.md already settled on for
    the C/D/E/F/G/A/B note keys (tuned live on the project's real WS2812
    ring) rather than generic rainbow guesses.
    [led_ring16_test.py]
2026-08-20 Fix rebuild guide's Python-package step: needs sudo, not plain pip3
    Section 5's install command and its verification step both ran
    unprivileged, so following this guide exactly still leaves root (the
    user chromacade.service and every WS2812 testing/ script actually run
    as) with none of the Adafruit CircuitPython stack -- the precise bug
    docs/decision-log.md's 2026-08-15 entry already documented and warned
    against, reintroduced by this guide not following its own project's
    lesson when it was written.
    Found 2026-08-20: `sudo python3 led_ring16_test.py` failed with
    ModuleNotFoundError on plinkplonk despite this guide having been
    followed -- root had zero of these packages, plink user had all o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
2026-08-20 Swap led_ring16_test.py to generic RGB values, not the tuned palette
    Requested: plain textbook colors for this candidate ring's bench test,
    not a comparison against docs/color-palette.md's hand-tuned note
    palette. Full-saturation primaries for red/green/blue (matching
    led_ring_test.py's own COLOR_STEPS), standard CSS named-color values
    for orange/yellow/purple/pink.
    [led_ring16_test.py]
2026-08-20 Add --rgb single-color hold mode for live palette tuning
    Bench-testing the candidate 16-LED ring against generic RGB values
    showed the expected WS2812 mixed-color skew (green reads stronger than
    its numeric value -- orange skews yellow, yellow skews green, purple/
    pink lose their red-blue balance) -- the same effect docs/color-
    palette.md already tuned around for the project's real ring. Tuning
    values live means trying many candidates in quick succession; a full
    edit-commit-push-pull round trip per attempt is too slow for that.//
    --rgb R,G,B skips the sequence, holds one color until Ctrl+C, so values
    can be tried directly on-device.
    [led_ring16_test.py]
2026-08-20 Tune orange to (255,50,0) for the candidate 16-LED ring
    Live-tuned via --rgb: generic CSS orange (255,165,0) read as too
    yellow on this ring, matching the green-reads-strong effect
    docs/color-palette.md documented for the project's real ring. Green
    reduced from 165 to 50 (confirmed against the middle of a commonly-
    cited WS2812 orange range, 50-100). Yellow/purple/pink still generic,
    not yet re-checked against this ring.
2026-08-20 Tune yellow/purple/pink for the candidate 16-LED ring
    Completes the live-tuning pass started with orange -- all 7 colors now
    confirmed against this specific ring via --rgb:
    yellow (255,190,0), was CSS (255,255,0)
    purple (10,0,24), was CSS (128,0,128)
    pink (255,0,100), was CSS (255,192,203)
    Purple needed far lower overall brightness, not just channel
    rebalancing -- at CSS brightness it read as pink, the same washed-out-
    pastel effect docs/color-palette.md documented for the project's real
    ring's keycap-derived values.
2026-08-20 Re-tune yellow to (125,85,0) for the candidate 16-LED ring
    Second pass after seeing it in the full 7-color sequence rather than
    isolated via --rgb -- (255,190,0) no longer the fit once judged
    alongside the rest.
    [led_ring16_test.py]
2026-08-20 Add candidate NeoPixel Ring 16 bench test with tuned colors
    Branched off main specifically so this can reach chromacade directly
    once it's accessible again, without dragging in the rest of the
    in-progress enclosure work living on shane/enclosure-scale-and-combine.
    Bench test for a candidate 16-LED ring being evaluated as a possible
    swap-in for the project's decided 7-LED ring -- not itself a decided
    part yet. Wired to GPIO12/physical pin 32 (confirmed live via pinctrl
    on plinkplonk; physical pin 12 is GPIO18, already claimed by this
    build's I2S audio for BCLK). All 7 colors live-tuned against this
    specific ring's hardware via the script's --rgb single-color hold
    mode: red/green/blue needed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
    [led_ring16_test.py]
2026-08-20 Retune the real ring's NOTE_COLORS to the candidate-ring tuning session's values
    Not using the candidate 16-LED NeoPixel ring for note display -- but
    the colors discovered tuning it (testing/led_ring16_test.py's --rgb
    mode) replace the project's decided ring's palette in led_ring.py,
    the actual code driving it. docs/color-palette.md updated to match,
    including a full recompute of the hue table and gap analysis --
    F->G is now the standout gap at 120 degrees (G moved from a
    green-tinted 217 degrees to a pure blue 240 degrees), worth keeping
    in mind for the still-open chord-blend work.
    Also fixes a pre-existing drift this surfaced: docs/color-palette.md's
    D was (255,45,0) while led_ring.py's D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
    [led_ring.py]
2026-08-20 Fix stale "no application code exists yet" claims across the docs
    CLAUDE.md's Repo state section (and its "no application/firmware
    Python code exists yet" line) described a phase of this project
    that's long past -- there's a real, tested application at the repo
    root now: chromacade.py (the unified app -- Play, menu, Tutor, Simon
    Says, all in one process) plus audio_engine.py, hardware_poller.py,
    menu.py, tutor_mode.py/tutor_songs.py, simon_sequences.py,
    sound_pools.py, led_ring.py/led_strip.py, oled_display.py,
    octave_gesture.py, and play.py (superseded but kept as a standalone
    dev tool). 165 pytest tests exist and pass -- confirmed by actually
    running the suite, not just counting files.
    Fo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
2026-08-20 Apply the same stale-docs fixes here (PR #28 only landed on main)
    This branch has its own copy of CLAUDE.md/audio/README.md/
    docs/open-questions.md/docs/task-breakdown.md/docs/chromacade-
    overview-and-tasks.md, independent of main's -- fixing the "no
    application code exists yet" staleness on a branch off main (PR #28)
    doesn't touch this branch's copies at all, and this branch won't get
    that fix until it eventually merges through plinkplonk -> main, if
    that even happens on this timeline. Reapplying the same fixes
    directly here since this is the branch actually in use right now.
    Same content as PR #28 with one difference: this branch's CLAUDE.md
    already had the enclosure section's pot-side/bl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
2026-08-20 Dim red/green/blue for the candidate 16-LED ring too
    Same treatment as yellow/purple: full-saturation primaries (255,0,0
    etc.) read too bright/washed-out on this ring, matching the pattern
    that already held for yellow and purple. Dimmed to (88,0,0)/(0,88,0)/
    (0,0,88).
2026-08-20 Re-tune orange to (88,15,0) for the candidate 16-LED ring
    Second pass, same dimming treatment as red/green/blue -- the earlier
    255,50,0 no longer fits alongside the dimmed set.
    [led_ring16_test.py]
2026-08-20 Re-tune pink to (88,0,35) for the candidate 16-LED ring
    Second pass, same dimming treatment as red/green/blue/orange -- the
    earlier 255,0,100 no longer fits alongside the dimmed set.
    [led_ring16_test.py]
2026-08-20 Re-tune yellow to (88,60,0) for the candidate 16-LED ring
    Third pass, now matching the same max-channel-88 dimming level as
    red/green/blue/orange/pink.
2026-08-20 Scale purple to (40,0,88) for the candidate 16-LED ring
    Brings purple onto the same max-channel-88 ceiling every other color
    in the set has now converged on. Updated the header comment too --
    it previously singled out purple as uniquely dim, no longer accurate
    now that the whole set matches.
    [led_ring16_test.py]
2026-08-20 Document the intensity-vs-distinctness finding from the 88-ceiling pass
    Comment-only. Seeing all 7 tuned colors together at once, not just
    individually via --rgb: lower intensity makes every color read more
    distinct and less washed-out-white, not only the colors that were
    visibly wrong at full brightness -- red/green/blue looked fine alone
    at full saturation but read better once compared side by side with
    the rest of the dimmed set. Sharper than color-palette.md's existing
    "additive light reads washed-out" point: this is specifically an
    intensity effect. Not yet ported to docs/color-palette.md or the real
    ring's led_ring.py -- this dimming pass has only happened on the
    candidate ring's test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
    [led_ring16_test.py]
2026-08-20 Nudge yellow green channel down to 55 for the candidate 16-LED ring
    Fourth pass, small nudge from 60.
2026-08-20 Brighten purple to (40,0,88) on the real ring, second pass
    Sean, watching the real ring directly on chromacade, judged the
    overall retune a "huge improvement" but noticed purple specifically
    still read dimmer than the rest of the set. First pass (10,0,24) had
    a max channel of just 24 while everything else in the set sits at
    88+ -- never got the same brightness pass the candidate ring's test
    script converged the whole set on. Brought up to (40,0,88), matching
    that same max-channel-88 ceiling. Hue barely moves (265 -> 267
    degrees) since this is a brightness fix, not a rebalance.
    docs/color-palette.md updated to match: table, hex/hue recompute, and
    the gap-analysis prose's A/B gap number (71 -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
    [led_ring.py]
2026-08-21 Close the toddler-accessible gap at front_bottom/top_back on blank-side
    pot-side is already printed (9-hour print) and can't change, so this
    fix lives entirely on blank-side. Real issue: the 0.15mm edge_clearance
    gap between this piece's strips and pot-side's endcap is a genuine
    through-slot, not just a cosmetic seam -- confirmed via the real-
    geometry interference check (translating the actual rendered pieces
    closer and re-checking), real margin was under 1mm, not the ~3mm first
    (wrongly) claimed after a coordinate mix-up mid-investigation.
    Adds two localized "bridge" features at exactly the two zones flagged
    live (front-wall near the p1 corner, top-segment near the p5 corner --
    where fron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
    [chromacade-blank-side.scad, chromacade-fit-check.scad]
2026-08-22 Add fluidsynth/pyfluidsynth to the rebuild guide -- missing entirely
    testing/fluidsynth_test.py failed with ModuleNotFoundError on
    plinkplonk despite the device having otherwise followed this guide
    front to back. Root cause: neither the apt packages (fluidsynth,
    fluid-soundfont-gm) nor the pip package (pyfluidsynth) were ever
    actually in this doc's own install commands -- docs/decision-log.md's
    2026-08-15 entry established that pyfluidsynth needs the same sudo-pip
    treatment as the Adafruit CircuitPython stack, but that only documented
    the convention, nobody had gone back and added the real install step
    here when this guide was written 2026-08-20.
    Fixed live on plinkplonk first (sudo apt ins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
2026-08-22 Disable onboard PWM audio -- another rebuild-guide gap, found live
    User noticed an unexpected "Headphones" (bcm2835) card in aplay -l on
    plinkplonk and asked why it had 8 subdevices -- that count itself is
    normal for this driver, but the card's presence at all isn't: this
    project already found and fixed this exact conflict on unit #1
    (2026-08-12, see hardware/gpio-pin-assignments.md) -- the Pi's onboard
    PWM audio path claims the same PWM0/PWM1 peripheral the LED ring
    (GPIO12) and strip (GPIO13) use for WS2812 data. That fix never made
    it into this guide when it was written for plinkplonk, so Raspberry Pi
    Imager's own dtparam=audio=on default quietly reintroduced the
    conflict on the new devic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
2026-08-23 WIP: shelf_d=60 + joystick reposition -- NOT ready to print
    Do not print blank-side from this commit -- panel_top's mounting boss
    renders as a disconnected floating island, confirmed via direct mesh
    connectivity analysis (2 separate solid components instead of 1).
    Root cause not fully identified yet.
    What's in this commit:
    - shelf_d: 1.875in+25% (47.625mm) -> 60mm, across all 4 files that
    share this constant (pot-side, blank-side, blank-side-embossed,
    fit-check). Shifts case_h from 104.915 to 106.637.
    - Speaker grilles reverted from the 2026-08-19 dual-cone housing
    (didn't fit when printed) back to the original two-single-driver
    design (spk_grille_w/h, spk_cx=45) -- see hardware/s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
    [chromacade-blank-side-embossed.scad, chromacade-blank-side.scad, chromacade-fit-check.scad, chromacade-pot-side.scad]
2026-08-23 Remove the front_bottom/top_back gap-lip bridges -- not effective
    Confirmed by direct visual inspection: despite passing the CSG
    interference check against pot-side's real geometry, the bridges
    didn't actually close anything -- the window where the two pieces
    don't meet along X at the bottom-front/top-back is still there, and
    the bridges just floated nearby without addressing it. Removed rather
    than left in as pointless geometry.
    The underlying problem (pot-side/blank-side not meeting across the
    full X width at either the bottom-front or top-back corner) is still
    open. Full history of the three iterations that were tried and found
    insufficient is preserved in git log for this file, not repe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
    [chromacade-blank-side.scad, chromacade-fit-check.scad]
2026-08-23 Fix seam_margin mismatch (1 vs 3) -- the actual cause of the gap, set to 0
    This, not edge_clearance, was the real reason the two pieces don't
    meet along X at the bottom-front/top-back (the "window" reported after
    removing the ineffective gap-lip bridges). pot-side.scad had
    seam_margin=1, blank-side.scad had seam_margin=3 -- mismatched, not a
    deliberate matched reveal -- consistently wrong the same way across
    all 4 files that carry a copy (pot-side, blank-side, blank-side-
    embossed, fit-check's two copies). Set to 0 in all of them per direct
    instruction.
    The original non-zero margin existed for a real, previously-documented
    reason (outer_profile()'s corner rounding doesn't pass exactly throu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
    [chromacade-blank-side-embossed.scad, chromacade-blank-side.scad, chromacade-fit-check.scad, chromacade-pot-side.scad]
2026-08-24 Fix remaining hardcoded /home/shane paths breaking plinkplonk
    chromacade.py crashed on startup on plinkplonk with FileNotFoundError:
    sound_pools.py's NOPES_DIR/YAYS_DIR were still hardcoded to unit #1's
    builder path. Same bug class already fixed once for chromacade.service
    (2026-08-20) but never swept for elsewhere -- found four more instances:
    - sound_pools.py: NOPES_DIR/YAYS_DIR now derived from the module's own
    file location instead of hardcoded, so the fix holds for any future
    device/user, not just plink.
    - audio/boot_chime.sh: same portable-derivation treatment (this was also
    the reported "boot chime is broken too").
    - audio/chromacade-boot-chime.service, web/Caddyfile: per-devic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
    [sound_pools.py]
2026-08-24 Fix encoder_test.py: stale GPIO25/GPIO20 button pins, not GPIO7/8
    The octave/font encoder push-buttons moved to GPIO8/GPIO7 back on
    2026-08-14 (decision-log.md, gpio-pin-assignments.md, and
    hardware_poller.py's OCTAVE_BTN_PIN/FONT_BTN_PIN all already reflect
    this correctly) -- but this standalone bench-test script's default
    PINS dict and docstring were never updated, still pointing at the old,
    now-invalid GPIO25 (octave, solder-damaged pad) and GPIO20 (font,
    permanently claimed by I2S) assignments.
    Running the test with its defaults against real hardware therefore
    reads as "button presses aren't working" even though the actual wiring
    and firmware are both fine -- a false negative from testi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
    [encoder_test.py]
2026-08-24 Fix OLED display upside down: rotate rendered image 180 before push
    Panel is physically mounted/wired upside down relative to the SSD1306
    driver's default orientation (reported live 2026-08-24). Simpler and
    more portable to rotate the Pillow image before every push than to
    chase the driver's COM/segment-remap init commands -- centralized in
    one _push() helper so show_lines()/show_play() (and any future caller)
    get it for free instead of needing to remember it individually.
    [oled_display.py]
2026-08-24 Document Caddy web-server setup in the device rebuild guide
    Added as Section 9, verified live on plinkplonk 2026-08-24: apt install
    (available directly from Debian trixie's own repo, no third-party
    source needed), then the one real gotcha -- Caddy's packaged systemd
    unit correctly runs as its own unprivileged caddy user, but a fresh
    account's home directory is 700 by default, so caddy can't traverse
    into it to serve web/ at all until it's added to the checkout owner's
    group and that directory's permissions widened to let the group in
    (750, not world-readable). Then deploy the tracked Caddyfile over the
    package's placeholder default and restart.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
2026-08-24 Fix volume pot: direction re-inverted since the last rewiring
    pot_volume_fraction() was inverting to correct a wiring fact confirmed
    2026-08-14 (clockwise reads as lower voltage). Reported live 2026-08-24
    that clockwise now turns the volume DOWN, the opposite of wanted --
    most likely the ADS1115/pot rewiring done this session flipped which
    direction reads high vs low voltage. Removed the inversion to match
    the current wiring; if it flips again after a future rewiring,
    re-derive from a live loudness check rather than assuming a direction
    is permanent -- this is now the second time it's changed.
    Updated the three pot_volume_fraction tests (values and the one test
    name that asserted the old, n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
    [audio_engine.py, test_audio_engine.py]
2026-08-24 Fix chord timing: don't block button-press callbacks on display I/O
    Reported live 2026-08-24: 3-note chords played as a fast arpeggio
    instead of together on plinkplonk, worse on fast-decay voices (masked
    on sustained voices since earlier notes were still ringing by the time
    later ones finally fired). Not a CPU/hardware regression -- plink's a
    strictly faster board than unit #1's Pi Zero 2W (confirmed no thermal
    throttling, low load) -- the actual mechanism is architectural:
    note_on()/note_off() called update_ring()/update_play_oled(force=True)
    synchronously, in the same gpiozero button callback that fires
    audio.note_on(). gpiozero's current lgpio pin factory (confirmed
    active on plink) proc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
    [chromacade.py]
2026-08-27 Swap boot chime to yays/yuss.wav, install+enable both services on plinkplonk
    audio/zelda/OOT_Navi_Hello1.wav (the previous boot chime) is gitignored
    copyrighted third-party audio, and grab_navi_sounds.sh (its fetch script)
    is gitignored too -- neither exists anywhere on plinkplonk or this dev
    machine, only ever having lived on unit #1. chromacade-boot-chime.service
    failed every boot as a result (confirmed via an actual reboot test, not
    just one manual run -- ExecStart's aplay call exited 1, "No such file or
    directory"). Switched to audio/yays/yuss.wav, which is already
    git-tracked and present on both machines.
    Also: neither chromacade.service nor chromacade-boot-chime.service was
    actually i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
2026-08-27 Switch plinkplonk to headless boot, document it + the service install
    raspi-config nonint do_boot_behaviour B2 -- flips systemctl get-default
    to multi-user.target with console autologin, which is sufficient to
    keep graphical.target (and therefore lightdm/labwc/wf-panel-pi/wayvnc)
    from ever starting at boot without needing to separately disable
    lightdm.service itself. Investigated after a note-button responsiveness
    report: the desktop stack was running unconditionally alongside
    chromacade.service on a device that has no monitor attached in normal
    use. Verified via an actual reboot: pgrep for lightdm/labwc/wf-panel-pi/
    wayvnc all come back empty, chromacade.service still comes up clean.
    Also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
2026-08-27 Let Tutor/Simon keep going after finishing without a re-gesture
    Requested 2026-08-26: after a full Tutor song or Simon game completes,
    a parent previously had to redo the encoder-hold menu gesture to start
    another one -- annoying when a toddler just wants to keep playing.
    Adds a keep-going/stop prompt after the celebration instead of
    dropping straight to Play: F (green, CONTINUE_LETTER) starts the next
    song/sequence in the same mode (SONGS/SIMON_SOURCES, wrapping via the
    new _next_in_cycle()); C (red, STOP_LETTER) confirms and returns to
    Play, same terminal behavior as before. Reuses the existing note
    buttons rather than new hardware -- C is already red and F is already
    mint green (color-pal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
2026-08-27 Add prompts/ voice recordings: keepgoing.wav, alldone.wav
    Personal recordings for the keep-going/stop prompt added in the
    previous commit on this branch (audio/prompts/, sound_pools.py's
    KEEP_GOING_SOUND/ALL_DONE_SOUND) -- git-tracked same as audio/nopes/
    and audio/yays/, not third-party copyrighted content like
    audio/zelda/'s Navi clips (see .gitignore). Recorded directly onto
    plinkplonk and pulled here to commit (git identity isn't configured on
    that device's checkout).
    Verified: build_pools() now resolves both real paths instead of
    raising, full pytest suite still green (167 passed).
2026-08-27 Let the volume pot work during Tutor/Simon demo playback
    Found live 2026-08-26: volume_change() only acted on
    ("play", "tutor_active", "simon_active"), silently no-op-ing during
    "tutor_demo"/"simon_demo" (the watch-the-song-play-once phase before
    gameplay starts) -- the pot did nothing while play_demo()/
    play_simon_sequence() was running. Pre-existing, not introduced by the
    continue-prompt work, but more noticeable now that a song's demo can
    play multiple times in a row without a menu trip in between.
    octave_change()/accidental_change()/pitch_bend() have the same *_active-
    but-not-*_demo gap -- left alone since only volume was actually
    reported broken, noted in a comment in case it comes up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
    [chromacade.py]
2026-08-27 Announce both keep-going/stop options by voice, not just keep-going
    Requested 2026-08-26: the prompt should tell the listener both choices
    exist (matching the OLED, which already shows both), not just play
    keepgoing.wav and leave alldone.wav to a conditional confirmation only
    heard if red gets pressed. sound_pools.py gains play_wav_sequence() --
    plays a list of paths back to back (subprocess.run, blocking between
    each) rather than play_wav()'s fire-and-forget Popen, since two
    overlapping voice clips through the shared dmix device would garble
    into each other. _offer_continue() now announces keep_going then
    all_done via that.
    Also fixes an ordering bug this introduced before it ever shipped: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
    [chromacade.py, sound_pools.py]
2026-08-27 Coalesce Play-mode display refreshes to fix LEDs lagging behind keys
    Found live 2026-08-27: "the LEDs are not keeping up with the keys and
    notes." Root cause was a side effect of the 2026-08-24 chord-timing
    fix (backgrounding update_ring()/update_play_oled() so they can't
    block gpiozero's callback dispatch) -- that fix spawned a brand new
    thread per note_on()/note_off() call with no coalescing, so playing
    several notes in quick succession (a run, not just a chord) queued up
    threads faster than the I2C OLED write + NeoPixel show() could drain
    them. _display_lock only serializes access, it doesn't skip stale
    work, so the ring visibly cycled through a growing backlog of
    already-superseded state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
    [chromacade.py]
2026-08-27 Decouple ring refresh from OLED refresh -- OLED writes were still throttling the ring
    The previous fix (single _display_worker(), one Event) coalesced
    correctly but didn't fix the actual complaint -- confirmed live,
    "the lights can't keep up" even after that change. Measured directly
    on plinkplonk: ring.show() ~1.3ms/call, oled.show_play() ~179ms/call,
    about 140x slower. Since that single worker called update_ring() then
    update_play_oled() sequentially on ONE thread, every ring update was
    stuck waiting behind the OLED's slow I2C write -- capping the RING's
    effective refresh rate at the OLED's ~5.5/sec ceiling instead of its
    own much faster one, regardless of coalescing.
    Fixed by splitting i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
    [chromacade.py]
2026-08-27 Split the shared display lock so OLED writes can't block the ring
    Found live 2026-08-27: even after decoupling ring/OLED refreshes onto
    separate worker threads (previous commit), "once [the OLED] gets
    backed up the lag spills over into the LED ring." Root cause: both
    update_ring() and update_play_oled() still acquired the SAME
    _display_lock, so _ring_worker() had to wait for _oled_worker() to
    release it before doing its own much faster write -- and since
    _request_display_refresh() sets both Events together on every note
    press, this collision happened on nearly every press, not some rare
    edge case. The two workers were only decoupled in name.
    ring.show() (WS2812 PWM/DMA) and the SSD1306 I2C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
    [chromacade.py]
2026-08-27 Document disabling the red PWR LED in device-rebuild-guide.md
    Added to plinkplonk's /boot/firmware/config.txt 2026-08-27 (by direct
    edit on the device, documented here after the fact): the board's red
    power LED was shining through the translucent-PLA case, distracting
    for a toddler instrument. dtparam=pwr_led_trigger=default-on +
    dtparam=pwr_led_activelow=off is the standard way to kill it -- looks
    backwards at a glance ("default-on" to turn something off) since the
    activelow flip is what actually inverts the visible result, not the
    trigger setting -- worth the explanation so a future rebuild doesn't
    "fix" this back to a lit LED.
2026-08-27 Cycle the boot chime through 3 prompts instead of one fixed clip
    Requested 2026-08-27 -- a single fixed yays/yuss.wav (the fix right
    before this one) felt repetitive on every boot. Adds
    audio/prompts/{hello,whats_up,lets_go}.wav (personal recordings,
    git-tracked same as the other audio/ pools) and rewrites boot_chime.sh
    to cycle through them in order.
    True cycling, not random.choice, matching this project's established
    preference (sound_pools.py's Cycler docstring: no back-to-back
    repeats, even airtime, easier to reason about than random) -- but this
    script is a fresh process every boot, not part of the long-running
    chromacade.py process, so the current index can't just live in memory
    like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
2026-08-27 Ignore CONTINUE_LETTER/STOP_LETTER presses until the announcement finishes
    Found live 2026-08-27: "press red, it just goes back to Play and
    doesn't say anything." Root cause: app["state"] flips to
    "<mode>_await_continue" BEFORE _offer_continue()'s voice announcement
    (play_wav_sequence(), several real seconds for both clips) finishes --
    has to, otherwise a press during it hits the stale
    tutor_active/simon_active branch and crashes on a None session (fixed
    2026-08-26). But that meant a press landing DURING the announcement
    was already being fully acted on -- starting the next song, or firing
    _stop_after_complete()'s own play_wav() call -- while the
    announcement's own aplay processes were still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
    [chromacade.py]
2026-08-27 Don't replay all_done.wav on the STOP_LETTER press itself
    Direct feedback 2026-08-27: "It doesn't need to play that again. they
    already pressed the red button." all_done.wav already plays once, as
    part of _offer_continue()'s upfront announcement -- replaying the same
    clip on the press that CHOSE that option was redundant, not a fresh
    confirmation. _stop_after_complete() keeps its brief "ALL DONE!" OLED
    flash before returning to Play; only the audio call was removed.
    [chromacade.py]
2026-08-27 Correct CLAUDE.md: chromacade is not gone, it's at Sean's house on main
    Direct correction 2026-08-27: a prior session's "chromacade is gone"
    note (from a 2026-08-17 "the device... is no longer here" statement,
    apparently read as lost/destroyed) was wrong. It's the original unit,
    delivered to Sean's house for the kids to test day to day -- reachable
    only when online via Raspberry Pi Connect (no standing SSH alias like
    plink; a CLI tmux-VPN tool has worked before but is unreliable --
    default to the user running commands there themselves). Tracks main,
    not plinkplonk.
    Also documents a real, concrete consequence of that correction: main
    has zero commits plinkplonk doesn't already have (confirme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
2026-08-27 created new final versions of enclosure design
    [blank-side-final.scad, blank-side-one-off.scad, chromacade-blank-side-embossed.scad, chromacade-blank-side-embossed.stl, chromacade-blank-side.scad, chromacade-blank-side.stl, chromacade-fit-check.scad, chromacade-pot-side.stl]
2026-08-27 Preserving legacy versions
    [chromacade-back-panel.scad, chromacade-blank-side-embossed.scad, chromacade-blank-side-embossed.stl, chromacade-blank-side-thinner.scad, chromacade-blank-side.scad, chromacade-blank-side.stl, chromacade-fit-check-thinner.scad, chromacade-fit-check.scad]
2026-08-27 adjustments to joystick mount
    [blank-side-final.scad, blank-side-one-off.scad]
2026-08-28 Give Simon's famous-number source 3 difficulty tiers, not equal lengths
    Requested 2026-08-27: Golden Ratio shortest/easiest (10 digits,
    "1.618033988"), e medium (15 digits, "2.71828182845904"), Pi
    unchanged/longest-hardest (21 digits, kept as-is -- described as "the
    full 20," approximate). All three are irrational, so there's no
    natural stopping point in the number itself to tie a length to -- the
    digit counts were already an arbitrary cutoff before this, just an
    equal one across all three; now a deliberate ladder instead.
    [simon_sequences.py]
2026-08-29 Make OLED rotation per-device config, not a hardcoded shared constant
    Found live 2026-08-28: merging plinkplonk into main and pulling to
    chromacade flipped chromacade's display upside down. Root cause: the
    two units' OLED panels are physically mounted 180 degrees opposite
    each other, so DISPLAY_ROTATION_DEGREES as a single hardcoded value in
    shared code can never be right for both -- whichever device's fix
    landed in the file most recently silently breaks the other one on the
    next merge. Already hit this exact class of bug twice before this fix
    ("we had fixed it on chromacade and then had to fix on the
    plinkplonk"), just never generalized until asked to stop maintaining
    divergent branches ove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
    [oled_display.py]
